LPhat24/Battery-Management-System-NCKH2026/Hardware/Box/in mau/LargeEdge_Color2.pdf

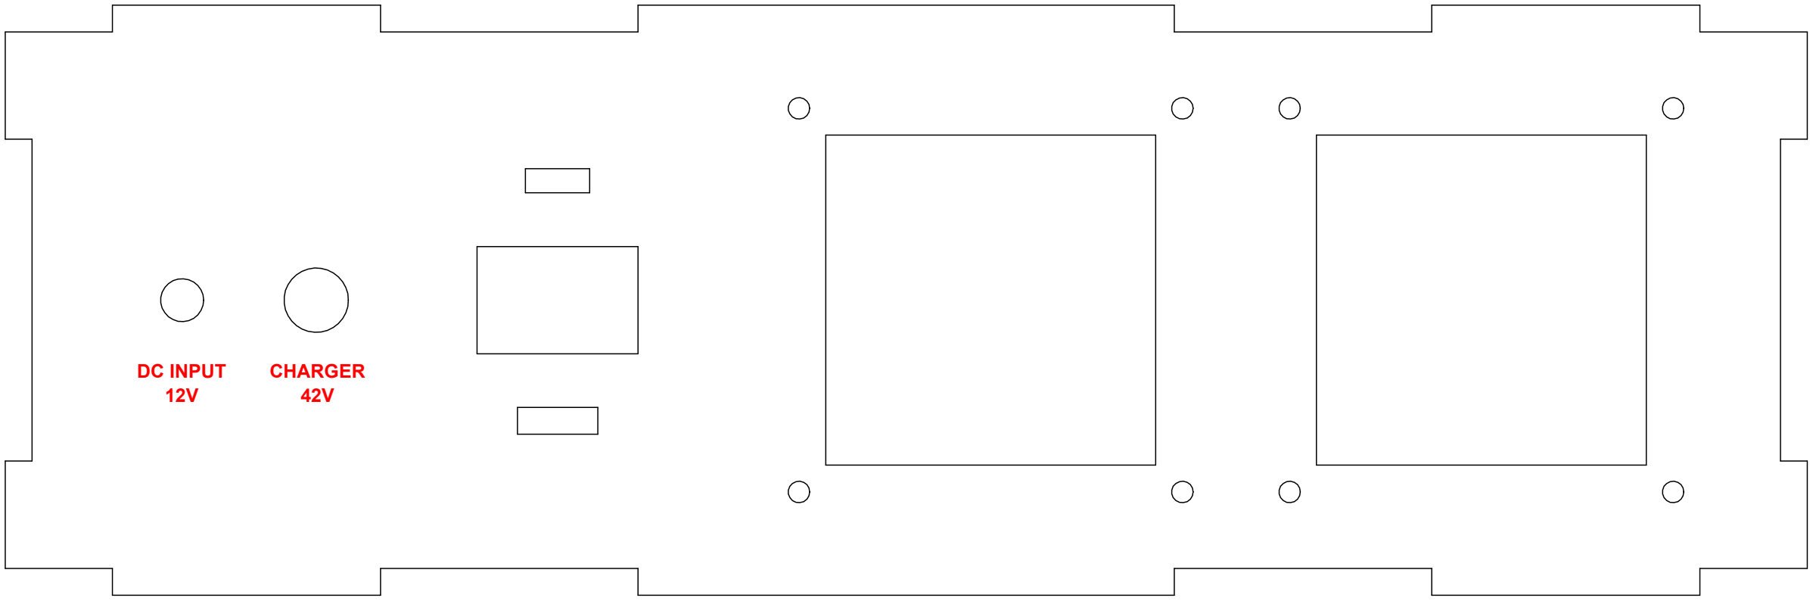
[picture p1: figure]
DC INPUT 12V; CHARGER 42V
