LPhat24/Battery-Management-System-NCKH2026/Hardware/Box/in mau/LargeEdge_Color.pdf

DC INPUT 12V; CHARGER 42V
