LPhat24/Battery-Management-System-NCKH2026/Docs/Huong Dan Host Repo.docx

# HƯỚNG DẪN DÀNH CHO LEADER REPOSITORY

## Dự án: Cruise Control DC Motor – LabVIEW & Arduino

Người quản lý Repository:

Le Thanh Phat

# 1. Trách nhiệm của Leader

Leader chịu trách nhiệm:

- Tạo và quản lý Repository GitHub.
- Thêm thành viên vào dự án.
- Quản lý cấu trúc thư mục.
- Kiểm tra lịch sử commit.
- Hỗ trợ xử lý lỗi Git.
- Tổng hợp source cuối cùng.
- Đảm bảo mọi người tuân thủ quy tắc làm việc.

# 2. Kiểm tra trạng thái Repository

git status

Ý nghĩa:

- Kiểm tra file mới.
- Kiểm tra file đã sửa.
- Kiểm tra trạng thái hiện tại của Repository.

Ví dụ:

nothing to commit, working tree clean

nghĩa là mọi thứ đã được đồng bộ.

# 3. Kiểm tra lịch sử Commit

git log --oneline

Ý nghĩa:

- Hiển thị toàn bộ lịch sử commit.
- Mỗi dòng là một phiên bản dự án.

Ví dụ:

a1b2c3d Doc: Add teamwork guide

e4f5g6h Initial project structure

# 4. Xem ai vừa Commit

git log

Ý nghĩa:

- Hiển thị:
  - Tên người commit.
  - Email.
  - Thời gian.
  - Nội dung commit.

Ví dụ:

Author: Nguyen Duy Thong

Date: ...

# 5. Kiểm tra Repository từ GitHub

git remote -v

Ý nghĩa:

- Hiển thị địa chỉ GitHub hiện tại.

Ví dụ:

origin https://github.com/xxxxx/Cruise-Control-DC-Motor-LabVIEW.git

# 6. Đồng bộ Repository

Trước khi làm việc:

git pull origin main

Ý nghĩa:

- Tải thay đổi mới nhất từ GitHub.

Nên thực hiện:

Mỗi ngày một lần.

hoặc

Trước khi bắt đầu làm việc.

# 7. Đẩy thay đổi của Leader

Thêm file:

git add .

Ý nghĩa:

- Thêm toàn bộ thay đổi vào vùng chuẩn bị commit.

Tạo commit:

git commit -m "Nội dung"

Ví dụ:

git commit -m "Doc: Update project guideline"

Đẩy lên GitHub:

git push origin main

Ý nghĩa:

- Upload commit từ máy tính lên GitHub.

# 8. Kiểm tra cây thư mục

tree /f /a

Ý nghĩa:

- Hiển thị toàn bộ file và thư mục.
- Dùng để kiểm tra thành viên có đặt file đúng vị trí hay không.

# 9. Kiểm tra thay đổi giữa các phiên bản

git diff

Ý nghĩa:

- So sánh file hiện tại với commit gần nhất.

# 10. Kiểm tra các file chưa được Git quản lý

git status

Ví dụ:

Untracked files:

Software/NguyenDuyThong/Test.ino

Ý nghĩa:

- Thành viên đã tạo file nhưng chưa commit.

# 11. Khôi phục file bị sửa

Khôi phục một file:

git restore <Tên file>

Ví dụ:

git restore README.md

Ý nghĩa:

- Hủy toàn bộ thay đổi chưa commit.

Cẩn thận vì không thể hoàn tác.

# 12. Xem các Branch

git branch

Ý nghĩa:

- Hiển thị các nhánh hiện có.

Ví dụ:

* main

# 13. Kiểm tra ai chưa Pull

Không có lệnh Git nào cho biết chính xác ai chưa Pull.

Leader nên yêu cầu thành viên:

git status

Nếu hiện:

Your branch is up to date with 'origin/main'

thì thành viên đã đồng bộ.

# 14. Quy tắc quản lý dự án

Mỗi thành viên chỉ làm việc trong thư mục của mình.

Ví dụ:

Software/NguyenDuyThong/

LabVIEW/HuynhPhuocDo/

Document/NguyenTienPhat/

Không tự ý sửa file của người khác.

# 15. Quy tắc Commit

Nội dung commit phải rõ ràng.

Ví dụ:

git commit -m "Software: Add encoder calculation"

git commit -m "LabVIEW: Create dashboard UI"

git commit -m "Hardware: Update wiring diagram"

git commit -m "Doc: Update project report"

Không sử dụng:

git commit -m "update"

git commit -m "fix"

vì không thể biết đã thay đổi gì.

# 16. Quy trình kiểm tra cuối tuần

Leader thực hiện:

git pull origin main

↓

git log --oneline

↓

tree /f /a

↓

Kiểm tra:

- Ai đã commit.
- Ai chưa commit.
- File có đúng vị trí không.
- Có file rác hay không.

# 17. Bộ lệnh Leader cần nhớ

git status

Kiểm tra trạng thái.

git pull origin main

Cập nhật Repository.

git add .

Thêm thay đổi.

git commit -m "..."

Tạo phiên bản mới.

git push origin main

Đẩy lên GitHub.

git log --oneline

Xem lịch sử commit.

git remote -v

Kiểm tra liên kết GitHub.

tree /f /a

Kiểm tra cấu trúc dự án.

git diff

Kiểm tra nội dung thay đổi.

Mục tiêu của Leader:

1. Không để mất dữ liệu.

2. Không để xảy ra xung đột file.

3. Luôn biết ai đã thay đổi gì.

4. Đảm bảo Repository luôn ở trạng thái ổn định.
