LPhat24/Battery-Management-System-NCKH2026/Docs/Huong Dan Teamwork GitHub.docx

# HƯỚNG DẪN TEAMWORK GITHUB

## Dự án: Cruise Control DC Motor – LabVIEW & Arduino

# 1. Mục tiêu

Sử dụng GitHub để:

- Đồng bộ source code giữa các thành viên.
- Lưu lịch sử thay đổi của dự án.
- Tránh mất dữ liệu khi làm việc nhóm.
- Quản lý tài liệu, hình ảnh, phần cứng, LabVIEW và Arduino trên cùng một repository.

# 2. Cài đặt Git

Tải Git:

https://git-scm.com/download/win

Cài đặt mặc định:

Next → Next → Next → Finish

Kiểm tra Git:

git --version

Ý nghĩa:

- Hiển thị phiên bản Git đang cài.
- Nếu hiện số phiên bản thì Git đã hoạt động.

# 3. Cấu hình Git lần đầu

Chỉ thực hiện 1 lần trên máy tính.

Khai báo tên:

git config --global user.name "Nguyen Van A"

Ý nghĩa:

- Khai báo tên người thực hiện commit.

Khai báo email:

git config --global user.email "abc@gmail.com"

Ý nghĩa:

- Khai báo email liên kết với GitHub.

Kiểm tra cấu hình:

git config --list

Ý nghĩa:

- Hiển thị toàn bộ cấu hình Git hiện tại.

# 4. Clone dự án từ GitHub

Di chuyển tới nơi muốn lưu dự án:

cd D:\Project

Ý nghĩa:

- cd = Change Directory.
- Di chuyển tới thư mục D:.

Clone repository:

git clone <Link Repository>

Ví dụ:

git clone https://github.com/xxxxx/Cruise-Control-DC-Motor-LabVIEW.git

Ý nghĩa:

- Tải toàn bộ project từ GitHub về máy.

Đi vào thư mục dự án:

cd Cruise-Control-DC-Motor-LabVIEW

Ý nghĩa:

- Chuyển tới thư mục dự án.

# 5. Cấu trúc thư mục dự án

Document/
├── HuynhPhuocDo
├── LeThanhPhat
├── NguyenDuyThong
└── NguyenTienPhat

Hardware/
├── HuynhPhuocDo
├── LeThanhPhat
├── NguyenDuyThong
└── NguyenTienPhat

Image/
├── HuynhPhuocDo
├── LeThanhPhat
├── NguyenDuyThong
└── NguyenTienPhat

LabVIEW/
├── HuynhPhuocDo
├── LeThanhPhat
├── NguyenDuyThong
└── NguyenTienPhat

Software/
├── HuynhPhuocDo
├── LeThanhPhat
├── NguyenDuyThong
└── NguyenTienPhat

# 6. Quy tắc làm việc

Mỗi thành viên chỉ làm việc trong thư mục mang tên mình.

Ví dụ:

NguyenDuyThong:

LabVIEW/NguyenDuyThong/
Software/NguyenDuyThong/
Document/NguyenDuyThong/

HuynhPhuocDo:

LabVIEW/HuynhPhuocDo/
Software/HuynhPhuocDo/
Document/HuynhPhuocDo/

Không chỉnh sửa file của người khác nếu chưa trao đổi.

Mục đích:

- Tránh xung đột Git.
- Tránh ghi đè file LabVIEW.
- Dễ theo dõi công việc từng người.

# 7. Các lệnh kiểm tra cơ bản

Hiển thị cây thư mục:

tree /f /a

Ý nghĩa:

- Hiển thị toàn bộ file và thư mục.

Kiểm tra đang đứng ở đâu:

pwd

Ý nghĩa:

- Hiển thị thư mục hiện tại.

Kiểm tra trạng thái Git:

git status

Ý nghĩa:

- Xem file nào đã thay đổi.
- Xem file mới được tạo.
- Kiểm tra trạng thái repository.

# 8. Quy trình làm việc hằng ngày

## Bước 1

Trước khi làm việc

git pull origin main

Ý nghĩa:

- Tải phiên bản mới nhất từ GitHub.
- Đồng bộ với các thành viên khác.

## Bước 2

Thực hiện công việc trong thư mục của mình.

Ví dụ:

LabVIEW/NguyenDuyThong/

hoặc

Software/HuynhPhuocDo/

## Bước 3

Kiểm tra thay đổi

git status

Ý nghĩa:

- Xem những file vừa chỉnh sửa.

## Bước 4

Đưa file vào vùng chuẩn bị commit

git add .

Ý nghĩa:

- Thêm toàn bộ thay đổi vào vùng chờ commit.

Dấu chấm . nghĩa là:

Thư mục hiện tại và toàn bộ thư mục con.

## Bước 5

Tạo commit

git commit -m "Mô tả công việc"

Ví dụ:

git commit -m "LabVIEW: Add dashboard interface"

hoặc

git commit -m "Software: Add encoder speed calculation"

Ý nghĩa:

- Lưu lại một phiên bản mới của dự án.
- Ghi chú nội dung công việc đã thực hiện.

## Bước 6

Đẩy lên GitHub

git push origin main

Ý nghĩa:

- Upload commit từ máy tính lên GitHub.

# 9. Bộ lệnh tối thiểu cần nhớ

Đi vào thư mục:

cd <Tên thư mục>

Ví dụ:

cd Software

Quay lại một cấp:

cd ..

Kiểm tra trạng thái:

git status

Tải cập nhật mới nhất:

git pull origin main

Thêm thay đổi:

git add .

Tạo commit:

git commit -m "Nội dung công việc"

Đẩy lên GitHub:

git push origin main

Xem cây thư mục:

tree /f /a

# 10. Quy trình chuẩn cần nhớ

Mỗi lần làm việc:

git pull origin main

↓

Thực hiện công việc

↓

git status

↓

git add .

↓

git commit -m "Mô tả công việc"

↓

git push origin main

Chỉ cần nhớ đúng quy trình trên là có thể làm việc nhóm an toàn trên GitHub.
