LPhat24/Battery-Management-System-NCKH2026/Docs/MASTER PCB/LAYOUT/BOTTOM LAYER.png

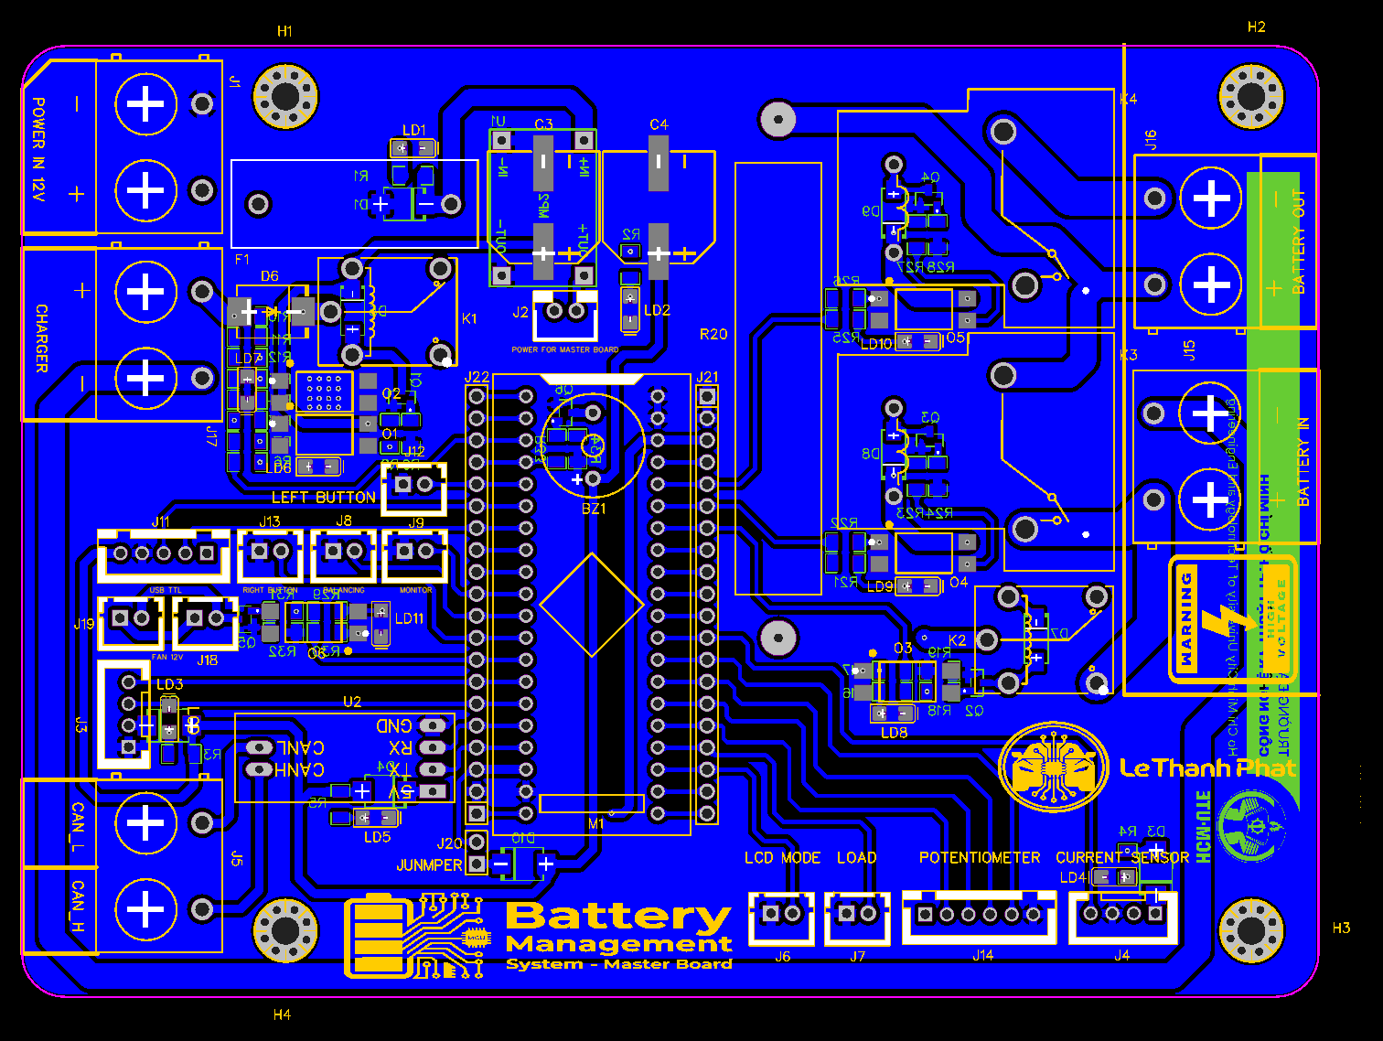
Docs/MASTER PCB/LAYOUT/BOTTOM LAYER.png
