LPhat24/Battery-Management-System-NCKH2026/Docs/MASTER PCB/SCHEMATIC/Schematic_PCB_VIP_Master-BMS-2026_2026-09-06.png

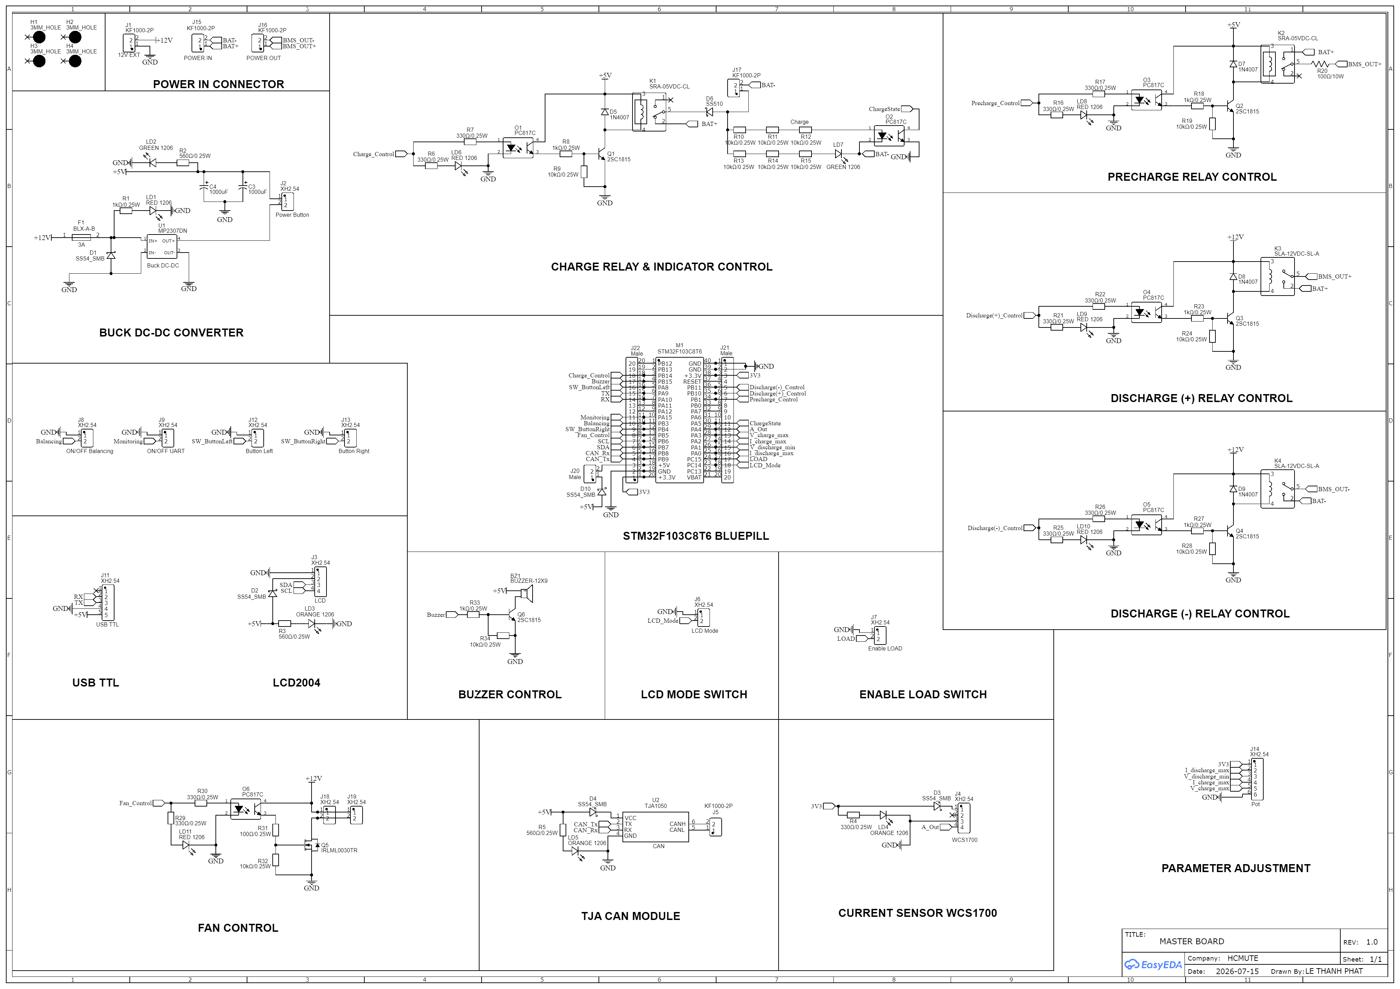
Docs/MASTER PCB/SCHEMATIC/Schematic_PCB_VIP_Master-BMS-2026_2026-09-06.png
