LPhat24/Battery-Management-System-NCKH2026/Docs/SLAVE PCB/LAYOUT/TOP LAYER.png

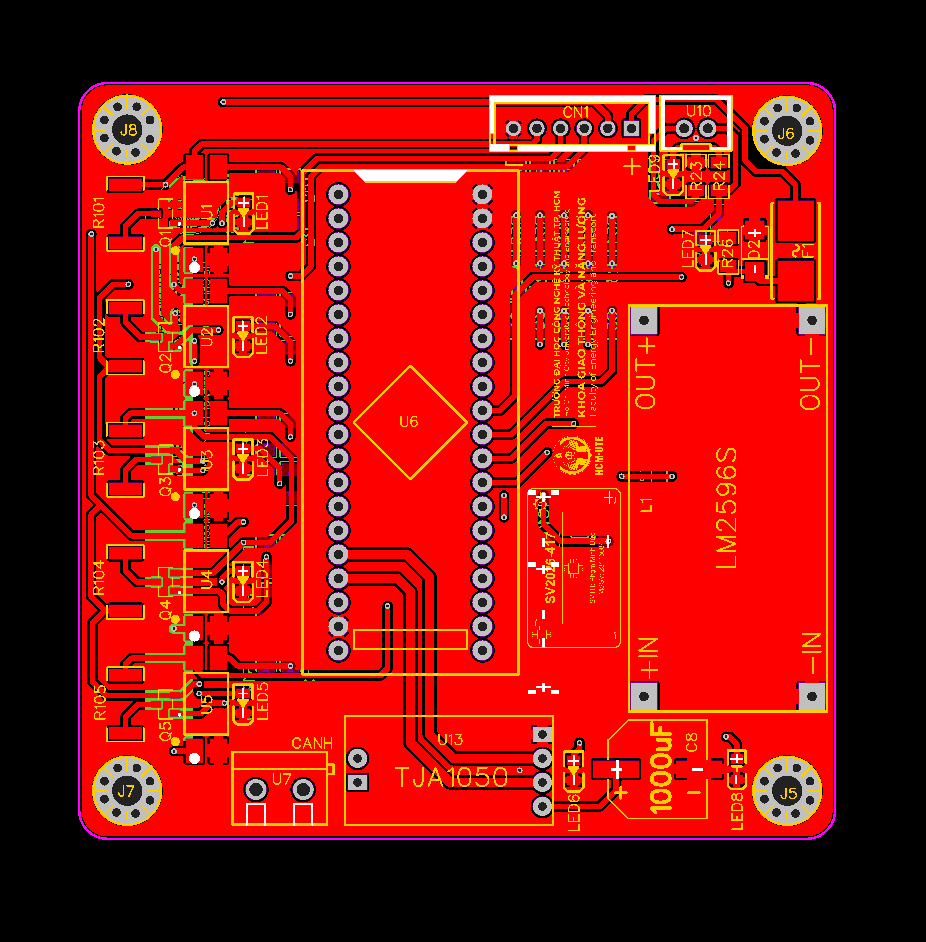
Docs/SLAVE PCB/LAYOUT/TOP LAYER.png
