LPhat24/Battery-Management-System-NCKH2026/Images/Screenshot 2026-09-05 204802.png

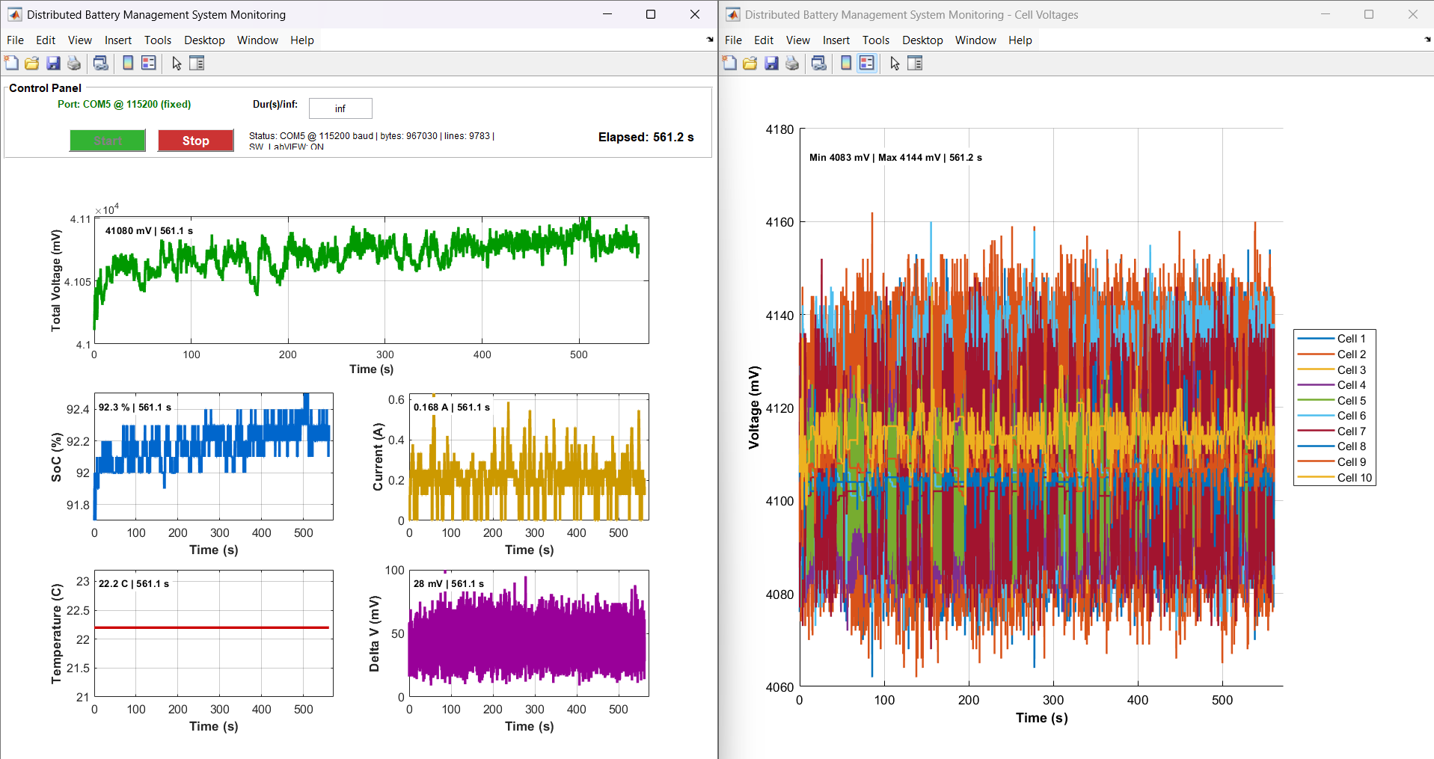
Images/Screenshot 2026-09-05 204802.png
