LPhat24/Battery-Management-System-NCKH2026/Hardware/Box/5s2p Battery.SLDASM

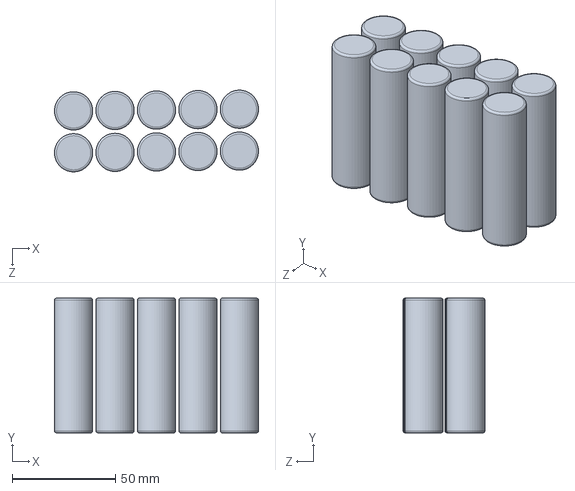
[picture p9: CAD file, 2026-08-03]
Hardware/Box/5s2p Battery.SLDASM
98.7 x 65.2 x 39.5 mm
Cell x 10
