LPhat24/Battery-Management-System-NCKH2026/Hardware/Box/Cat mica Box/LargeEdge.DXF

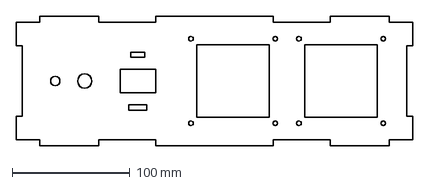
[picture p10: CAD file, 2026-08-04]
Hardware/Box/Cat mica Box/LargeEdge.DXF
336.0 x 110.0 mm
