LPhat24/Battery-Management-System-NCKH2026/Hardware/Box/Top.SLDPRT

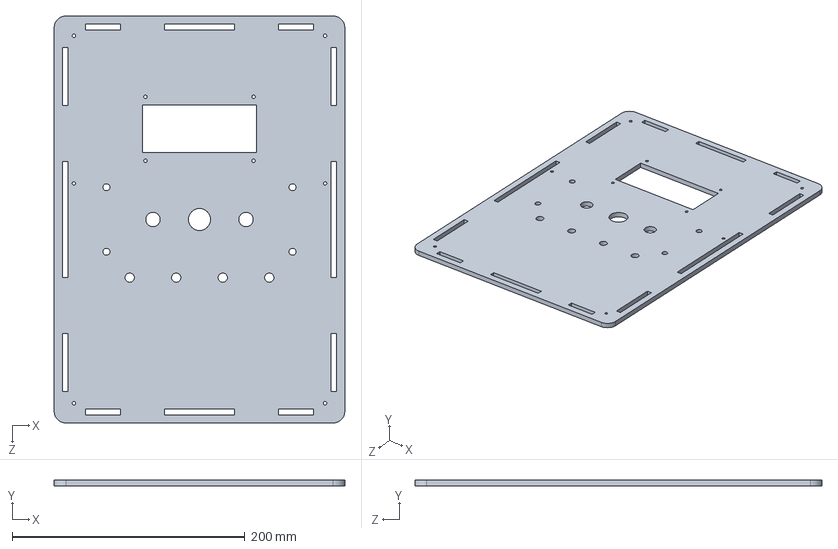
[picture p11: CAD file, 2026-08-04]
Hardware/Box/Top.SLDPRT
250.0 x 5.00 x 350.0 mm
