LPhat24/Battery-Management-System-NCKH2026/Hardware/Box/Cat mica Box/SmallEdge.DXF

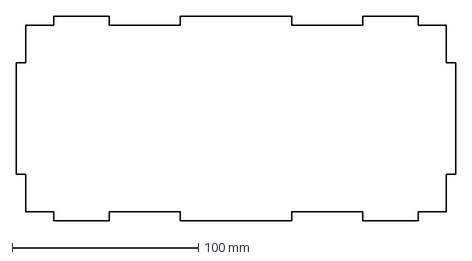
[picture p12: CAD file, 2026-08-04]
Hardware/Box/Cat mica Box/SmallEdge.DXF
236.0 x 110.0 mm
