LPhat24/Battery-Management-System-NCKH2026/Hardware/Box/rocker switch.SLDPRT

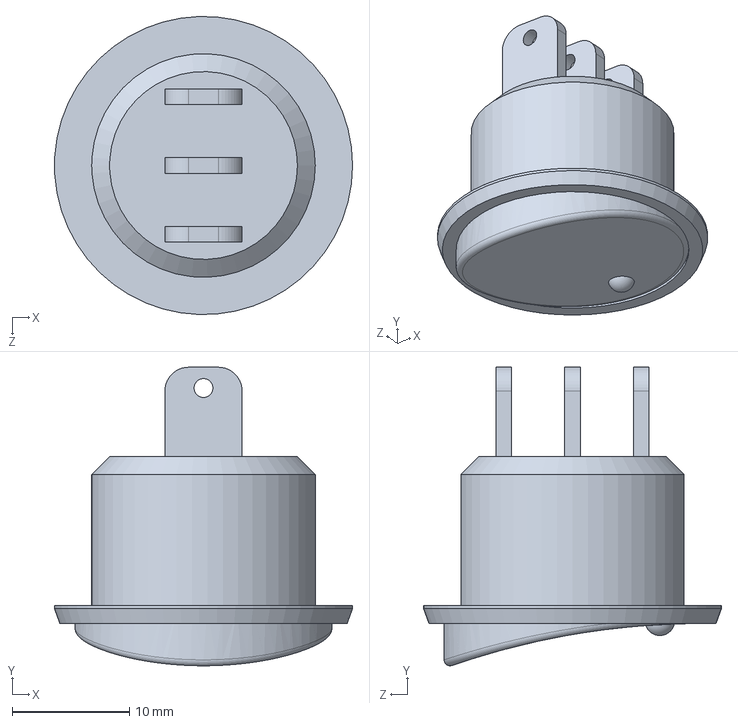
[picture p13: CAD file, 2026-08-03]
Hardware/Box/rocker switch.SLDPRT
25.4 x 25.4 x 25.4 mm
