LPhat24/Battery-Management-System-NCKH2026/Hardware/Box/Cat mica Box/LargeEdge_Right.DXF

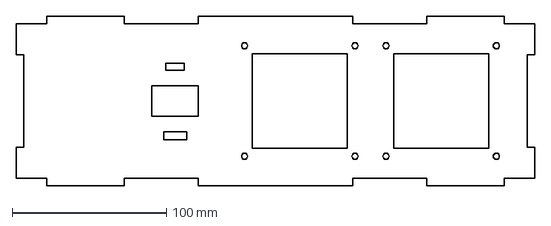
[picture p14: CAD file, 2026-08-04]
Hardware/Box/Cat mica Box/LargeEdge_Right.DXF
336.0 x 110.0 mm
