LPhat24/Battery-Management-System-NCKH2026/Hardware/Box/FAN_80x80x25.SLDPRT

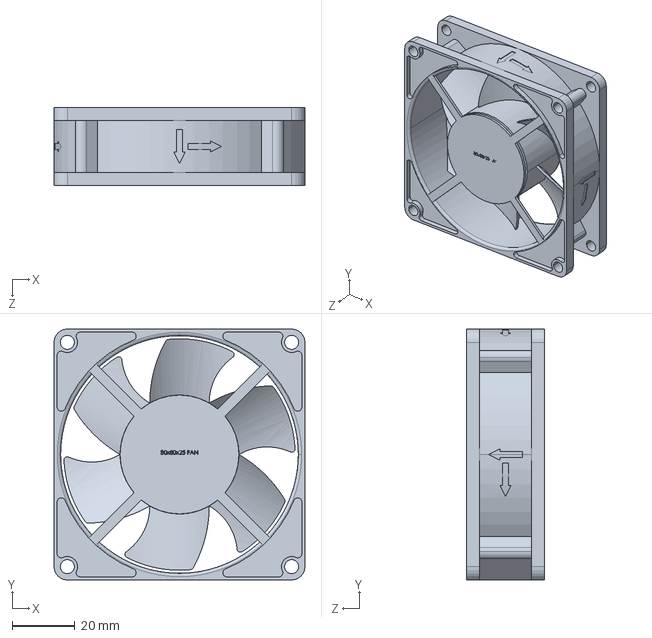
[picture p15: CAD file, 2026-08-03]
Hardware/Box/FAN_80x80x25.SLDPRT
80.0 x 80.0 x 25.0 mm
