LPhat24/Battery-Management-System-NCKH2026/Hardware/Box/Cat mica Box/Bottom2.DXF

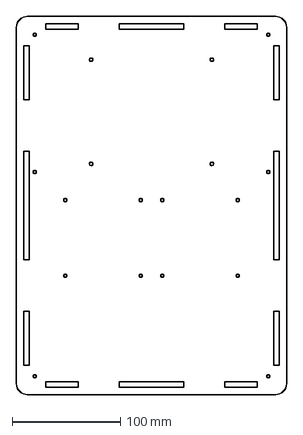
[picture p16: CAD file, 2026-08-04]
Hardware/Box/Cat mica Box/Bottom2.DXF
250.0 x 350.0 mm
