LPhat24/Battery-Management-System-NCKH2026/Hardware/Box/LargeEdge.SLDPRT

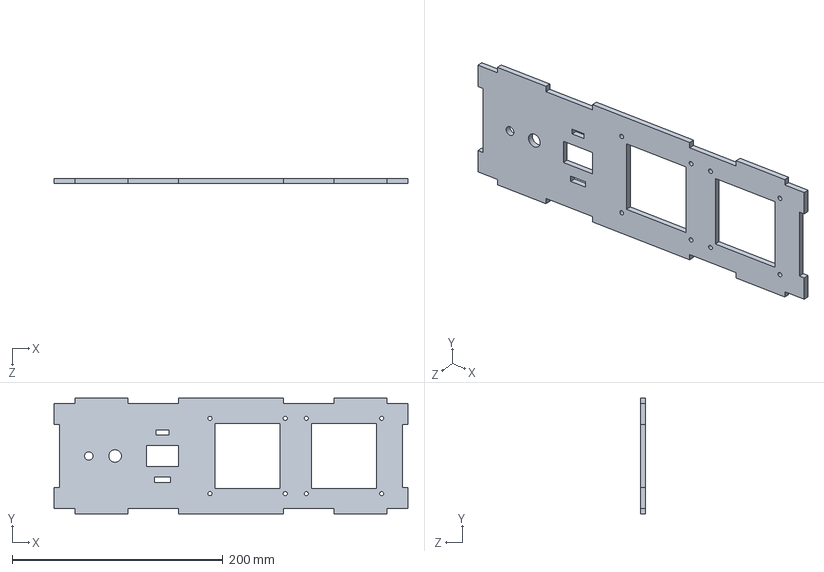
[picture p17: CAD file, 2026-08-03]
Hardware/Box/LargeEdge.SLDPRT
336.0 x 110.0 x 5.00 mm
