LPhat24/Battery-Management-System-NCKH2026/Hardware/Box/Cat mica Box/Top.DXF

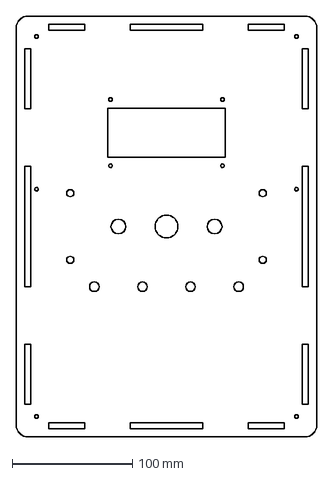
[picture p18: CAD file, 2026-08-04]
Hardware/Box/Cat mica Box/Top.DXF
250.0 x 350.0 mm
