LPhat24/Battery-Management-System-NCKH2026/Hardware/Box/Potentiometer.SLDPRT

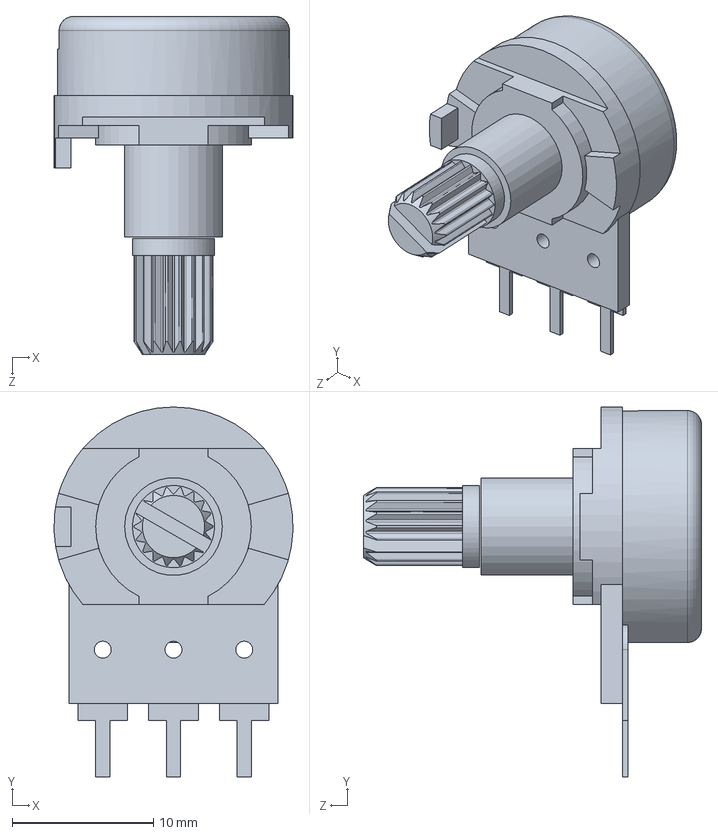
[picture p19: CAD file, 2026-08-03]
Hardware/Box/Potentiometer.SLDPRT
16.9 x 26.1 x 23.9 mm
