LPhat24/Battery-Management-System-NCKH2026/Hardware/Box/PCB_Standoff_50mm.SLDPRT

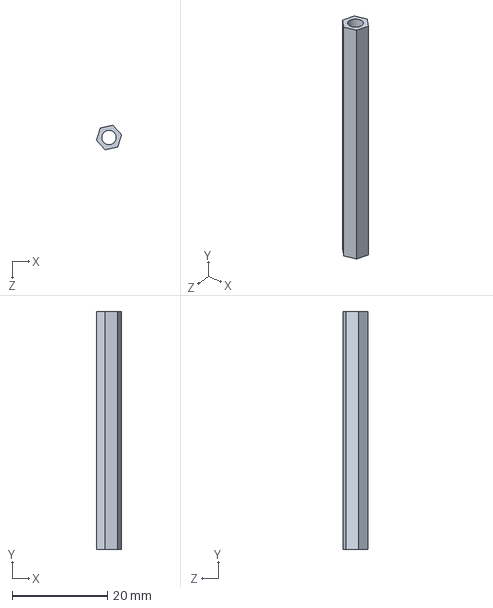
[picture p21: CAD file, 2026-08-03]
Hardware/Box/PCB_Standoff_50mm.SLDPRT
5.30 x 50.0 x 5.17 mm
