LPhat24/Battery-Management-System-NCKH2026/Hardware/Box/Bottom2.SLDPRT

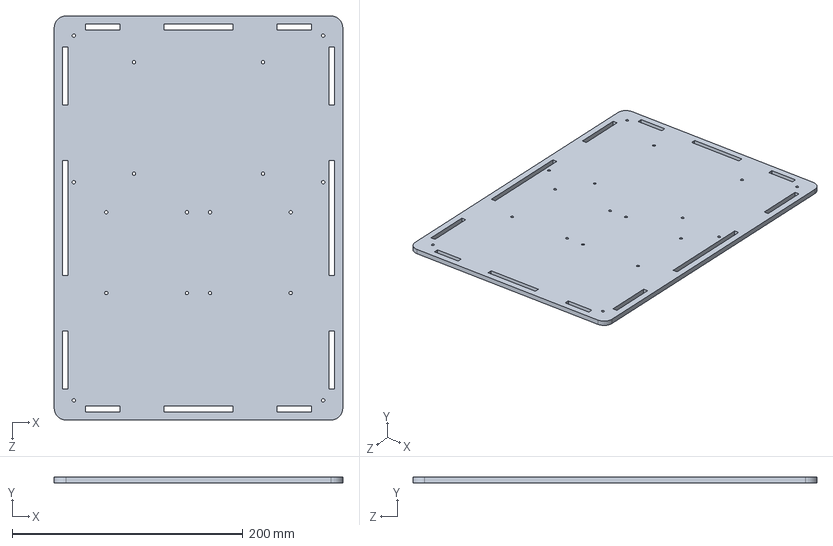
[picture p23: CAD file, 2026-08-03]
Hardware/Box/Bottom2.SLDPRT
250.0 x 5.00 x 350.0 mm
