LPhat24/Battery-Management-System-NCKH2026/Hardware/Box/Push Button.SLDPRT

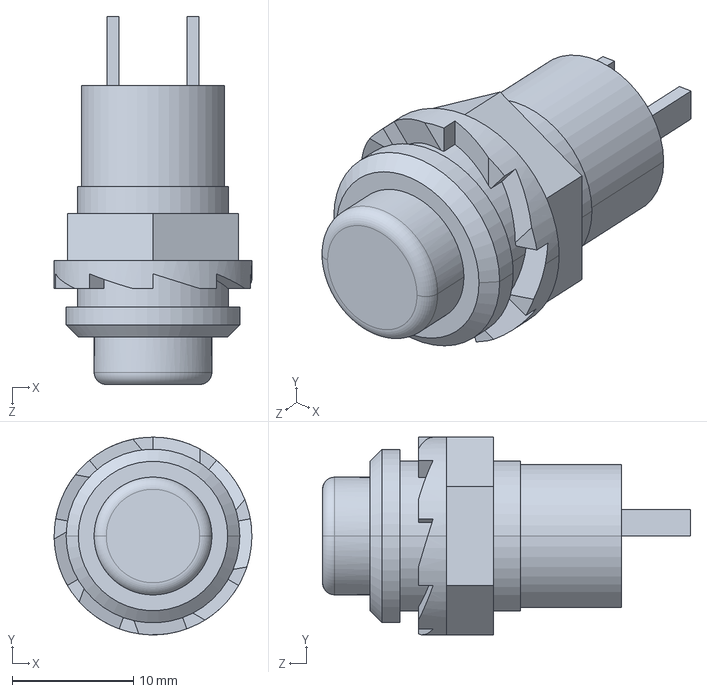
[picture p24: CAD file, 2026-08-03]
Hardware/Box/Push Button.SLDPRT
16.3 x 16.3 x 30.3 mm
