LPhat24/Battery-Management-System-NCKH2026/Hardware/Box/PCB_Standoff.SLDPRT

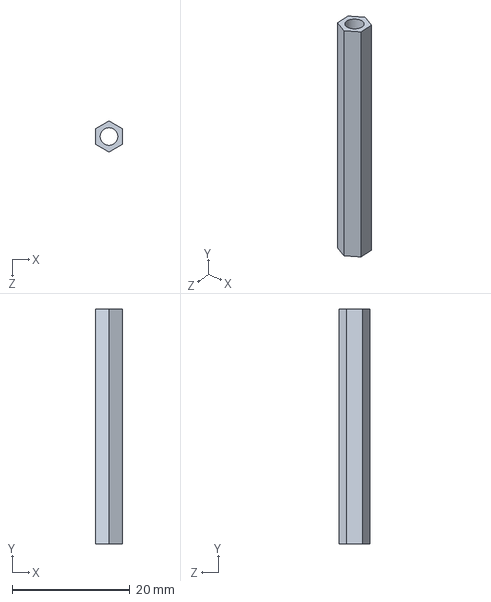
[picture p25: CAD file, 2026-08-03]
Hardware/Box/PCB_Standoff.SLDPRT
4.59 x 40.0 x 5.30 mm
