LPhat24/Battery-Management-System-NCKH2026/Hardware/Box/SmallEdge.SLDPRT

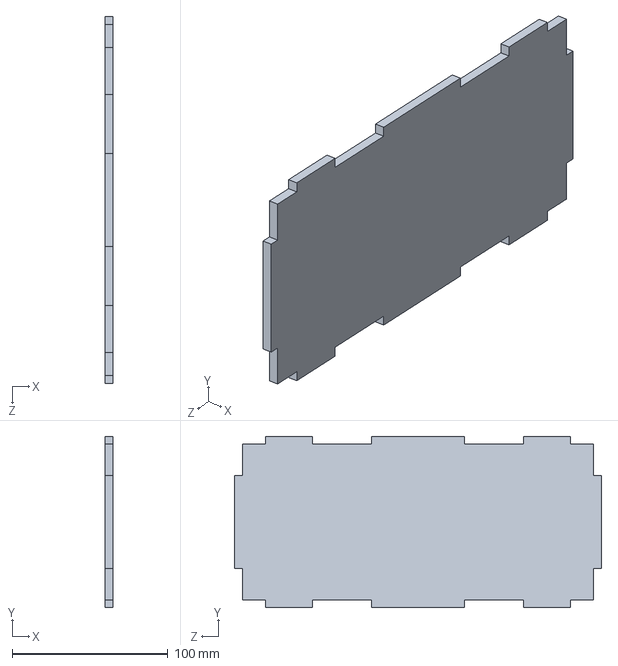
[picture p26: CAD file, 2026-08-03]
Hardware/Box/SmallEdge.SLDPRT
5.00 x 110.0 x 236.0 mm
