LPhat24/Battery-Management-System-NCKH2026/Hardware/Box/LCD 2004 +I2C.SLDPRT

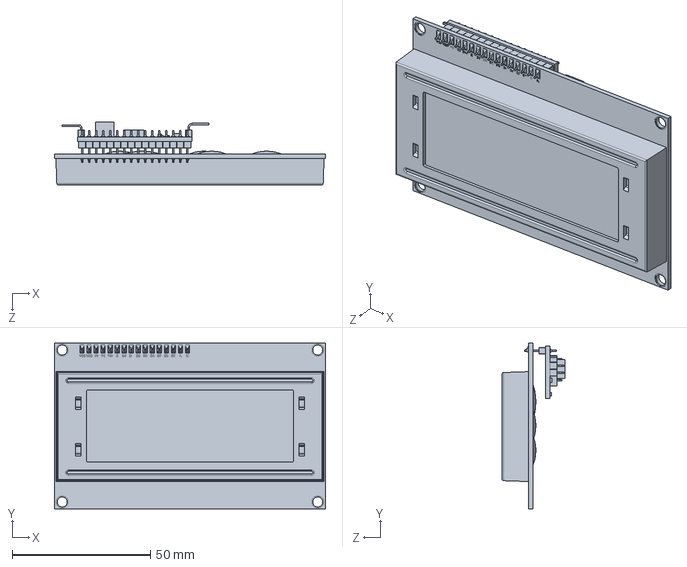
[picture p27: CAD file, 2026-08-03]
Hardware/Box/LCD 2004 +I2C.SLDPRT
98.1 x 60.1 x 22.7 mm
