LPhat24/Battery-Management-System-NCKH2026/Hardware/Box/MTS-102.SLDPRT

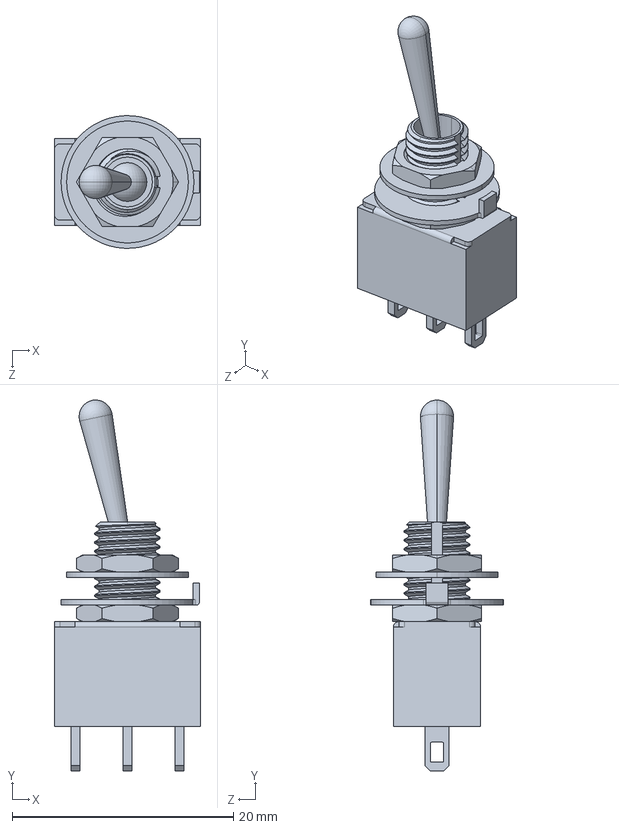
[picture p28: CAD file, 2026-08-03]
Hardware/Box/MTS-102.SLDPRT
13.2 x 33.5 x 12.0 mm
