LPhat24/Battery-Management-System-NCKH2026/Hardware/Box/Cell.SLDPRT

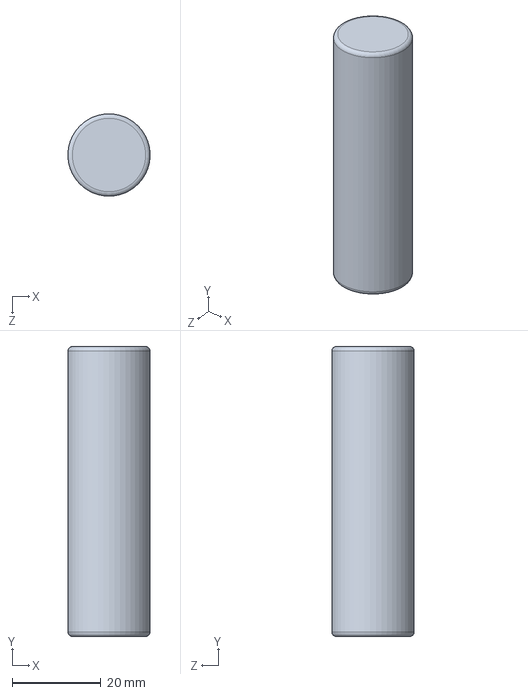
[picture p29: CAD file, 2026-08-03]
Hardware/Box/Cell.SLDPRT
18.5 x 65.2 x 18.5 mm
