LPhat24/Battery-Management-System-NCKH2026/(list of files, cad)

Other CAD files:
Hardware/Box/LargeEdge_Right.SLDPRT
Hardware/Box/18650 2PCS KEEPER.SLDPRT
Hardware/Box/LargeEdge.SLDDRW
Hardware/Box/SmallEdge_OUTPUT.SLDDRW
Hardware/Box/Top Custom.SLDDRW
