LPhat24/Battery-Management-System-NCKH2026/Images/FirstTest_Fig1_JPG.jpg

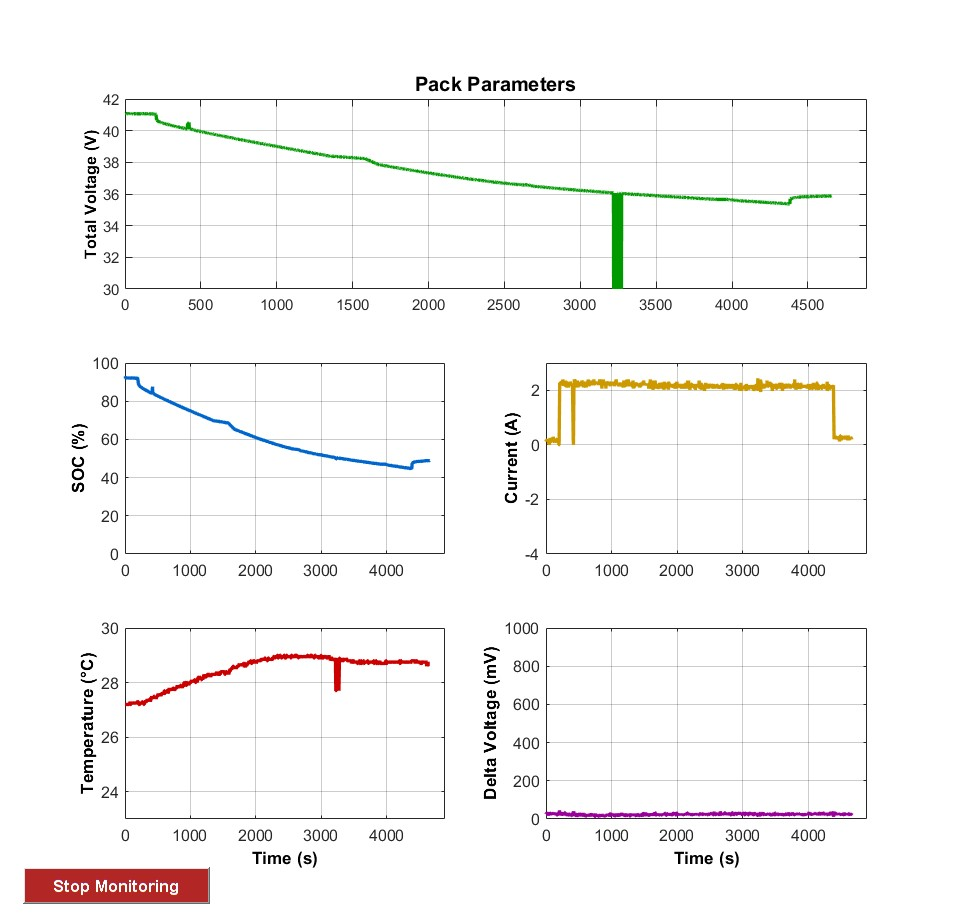
Images/FirstTest_Fig1_JPG.jpg
