LPhat24/Battery-Management-System-NCKH2026/Images/FirstTest_Fig2_JPG.jpg

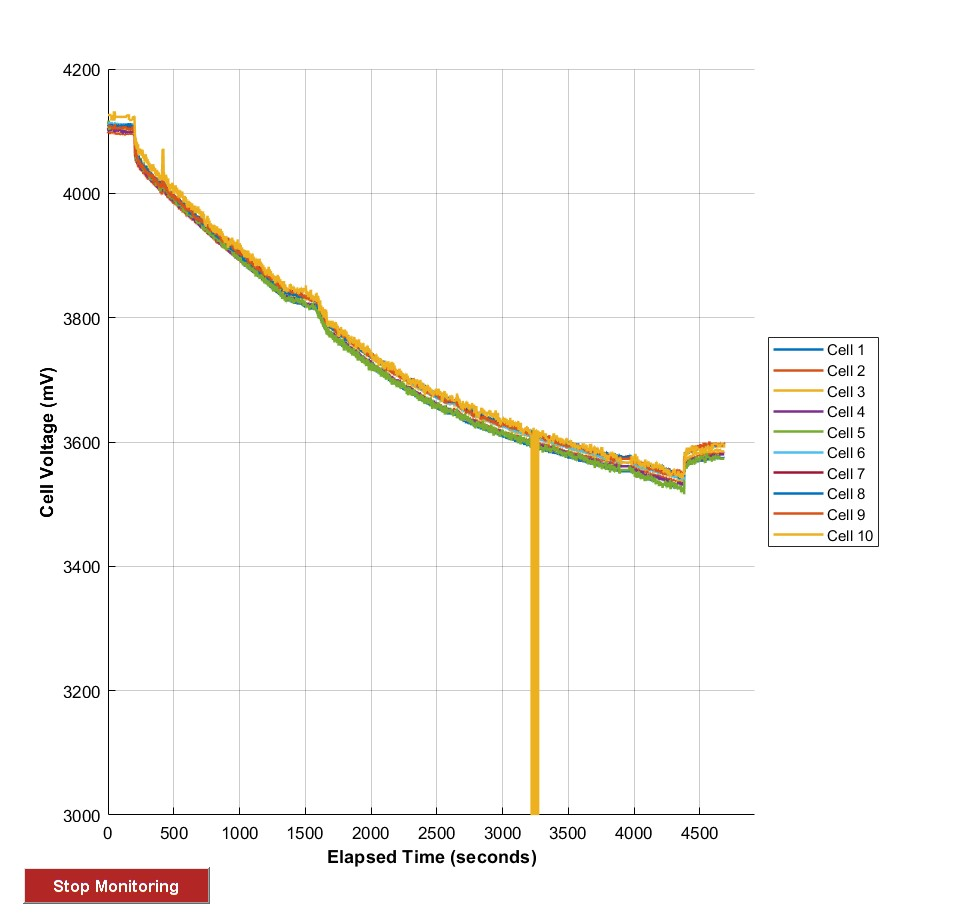
Images/FirstTest_Fig2_JPG.jpg
