LPhat24/Battery-Management-System-NCKH2026/Images/SecondTest_Fig1_JPG.jpg

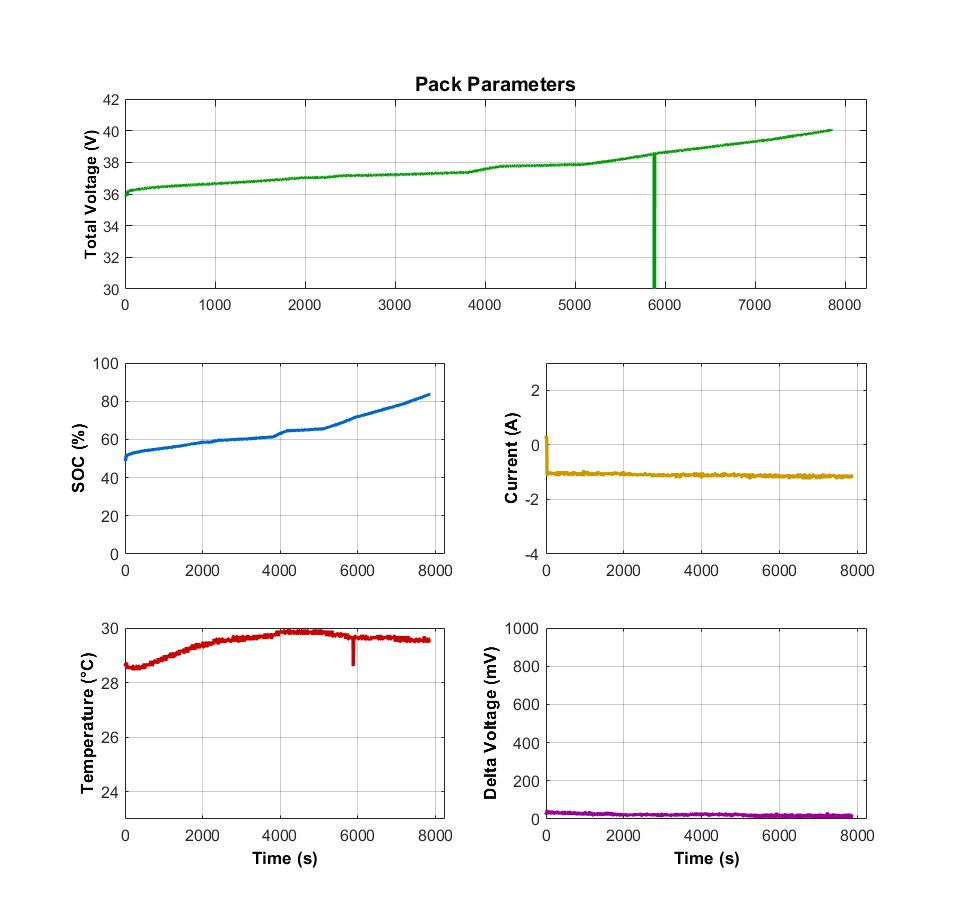
Images/SecondTest_Fig1_JPG.jpg
