LPhat24/Battery-Management-System-NCKH2026/Docs/MASTER PCB/SCHEMATIC/Schematic_PCB_VIP_Master-BMS-2026_2026-09-06.pdf

# POWER IN CONNECTOR

# PRECHARGE RELAY CONTROL

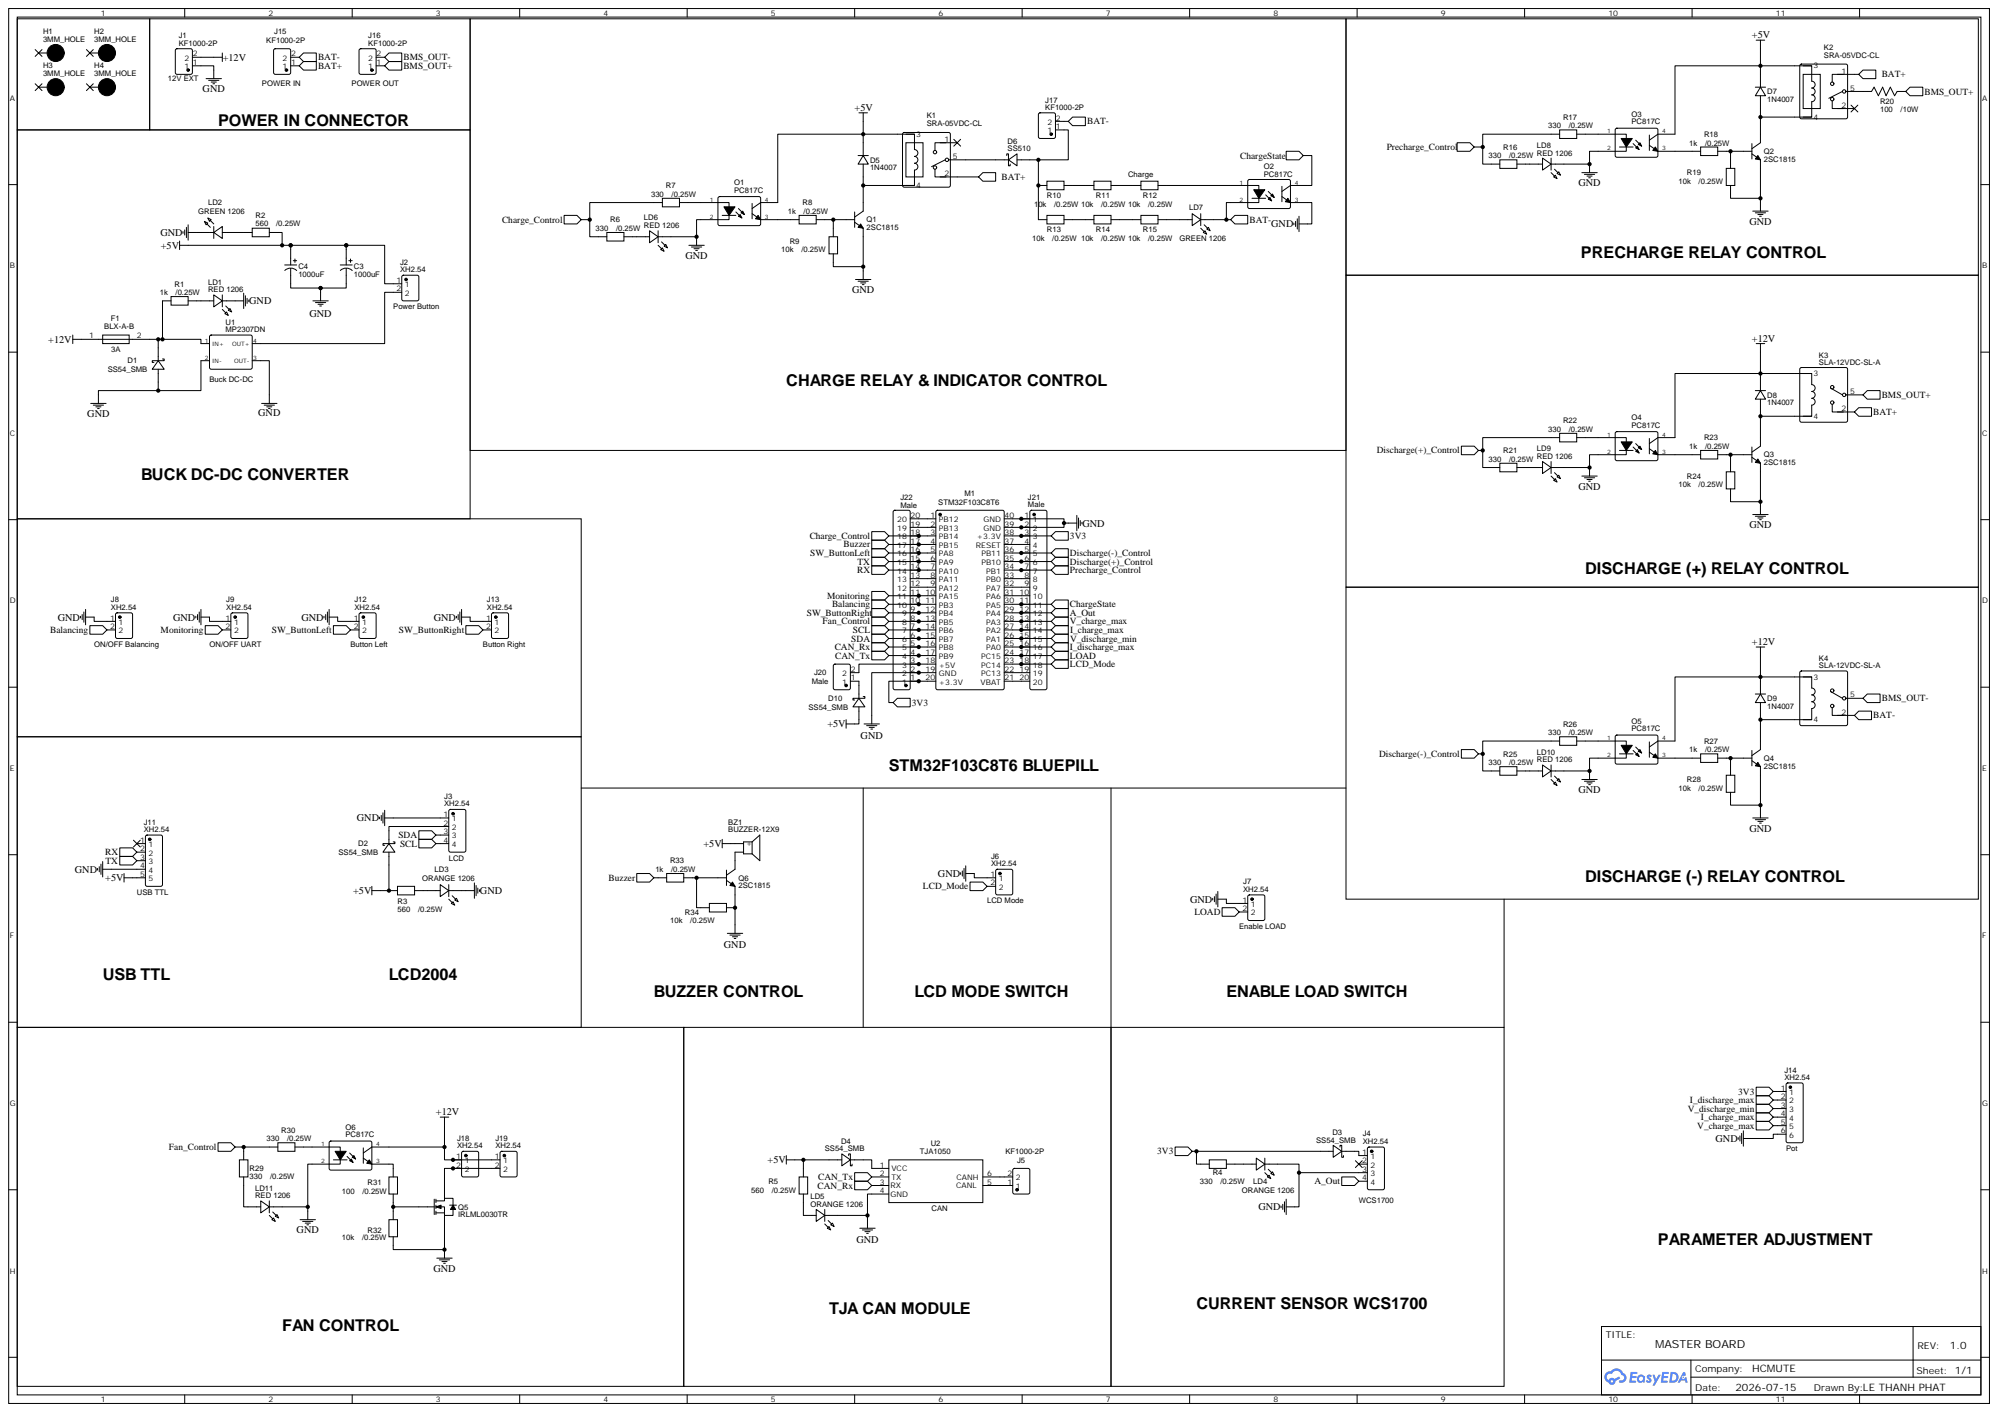
[picture p34: page 1]

CHARGE RELAY & INDICATOR CONTROL

BUCK DC-DC CONVERTER
