LPhat24/Battery-Management-System-NCKH2026/Hardware/Box/in mau/Top_Color2.pdf

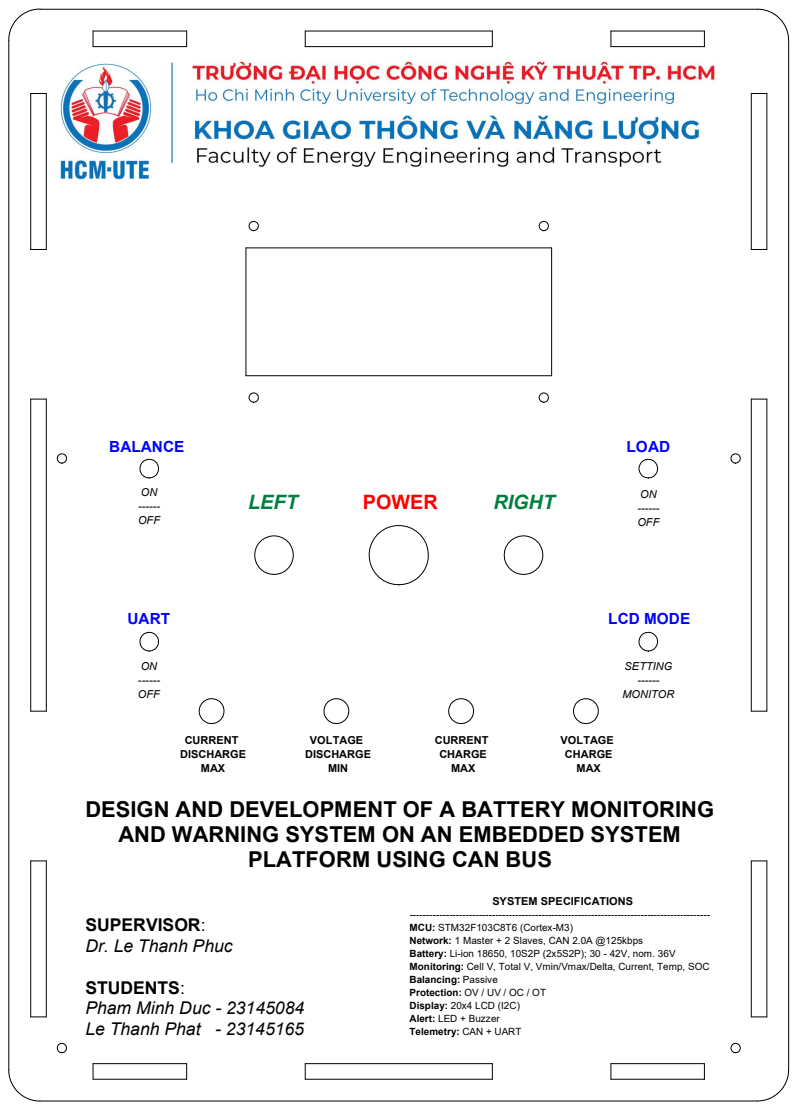
[picture p35: page 1]
BALANCE; LOAD; UART; LCD MODE; LEFT; POWER; RIGHT; OFF; MONITOR; SETTING; MIN; DISCHARGE; CURRENT; VOLTAGE; MAX; CHARGE; SYSTEM SPECIFICATIONS

DESIGN AND DEVELOPMENT OF A BATTERY MONITORING
AND WARNING SYSTEM ON AN EMBEDDED SYSTEM

PLATFORM USING CAN BUS

MCU: STM32F103C8T6 (Cortex-M3)
Network: 1 Master + 2 Slaves, CAN 2.0A @125kbps
Battery: Li-ion 18650, 10S2P (2x5S2P); 30 - 42V, nom. 36V
Monitoring: Cell V, Total V, Vmin/Vmax/Delta, Current, Temp, SOC
Balancing: Passive
Protection: OV / UV / OC / OT
Display: 20x4 LCD (I2C)
Alert: LED + Buzzer
Telemetry: CAN + UART

SUPERVISOR:
Dr. Le Thanh Phuc

STUDENTS
Pham Minh Duc - 23145084
Le Thanh Phat - 23145165
