LPhat24/Battery-Management-System-NCKH2026/Docs/SLAVE PCB/SCHEMATIC/Schematic_PCB_VIP-Slave-BMS-2026_2026-09-06.pdf

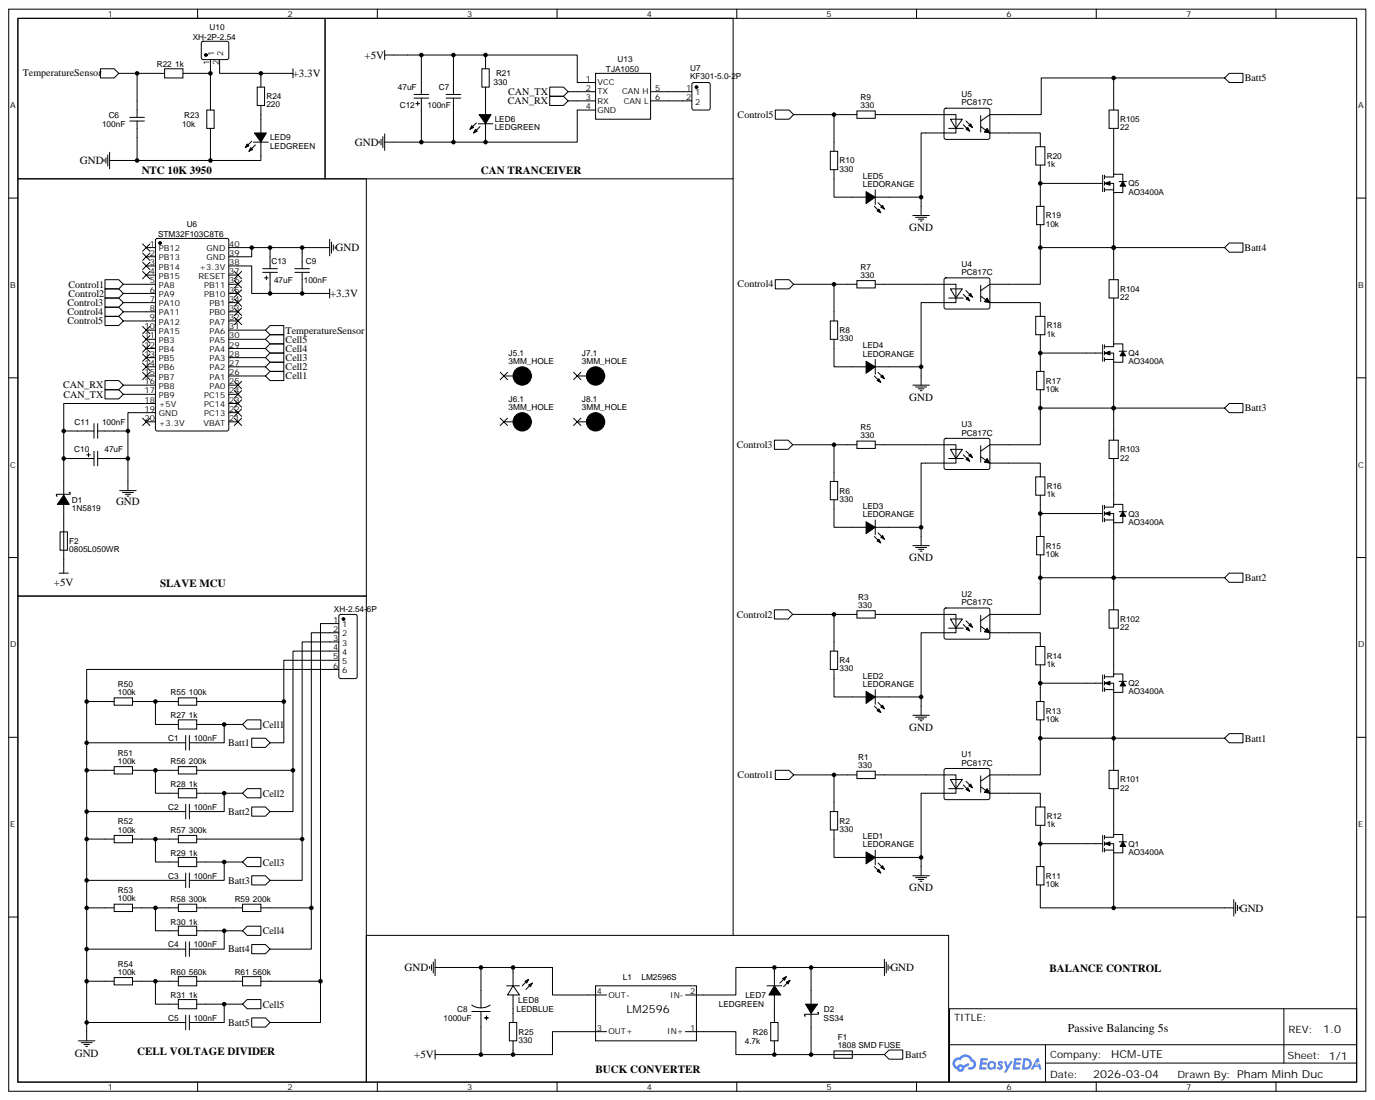
[picture p36: page 1]

Drawn By: Pham Minh Duc
