LPhat24/Battery-Management-System-NCKH2026/Docs/MASTER PCB/LAYOUT/BOTTOM LAYER.pdf

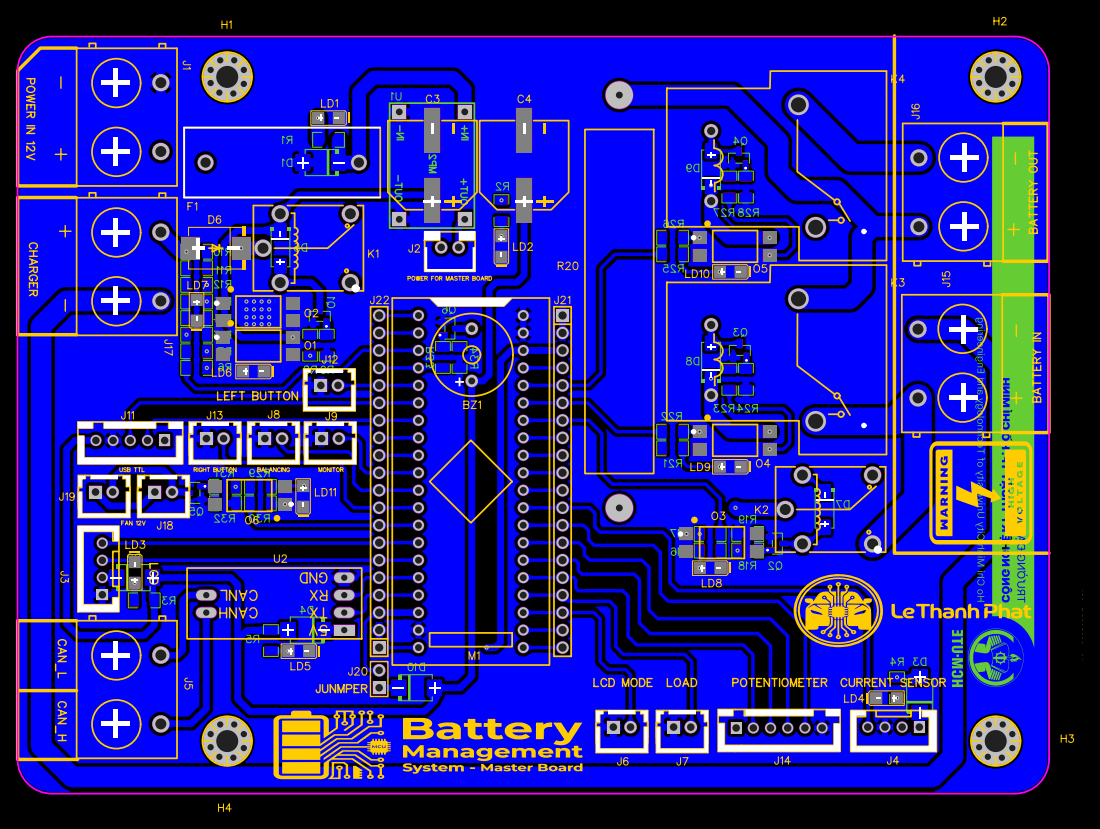
[picture p37: page 1]
