LPhat24/Battery-Management-System-NCKH2026/Docs/MASTER PCB/LAYOUT/TOP LAYER.pdf

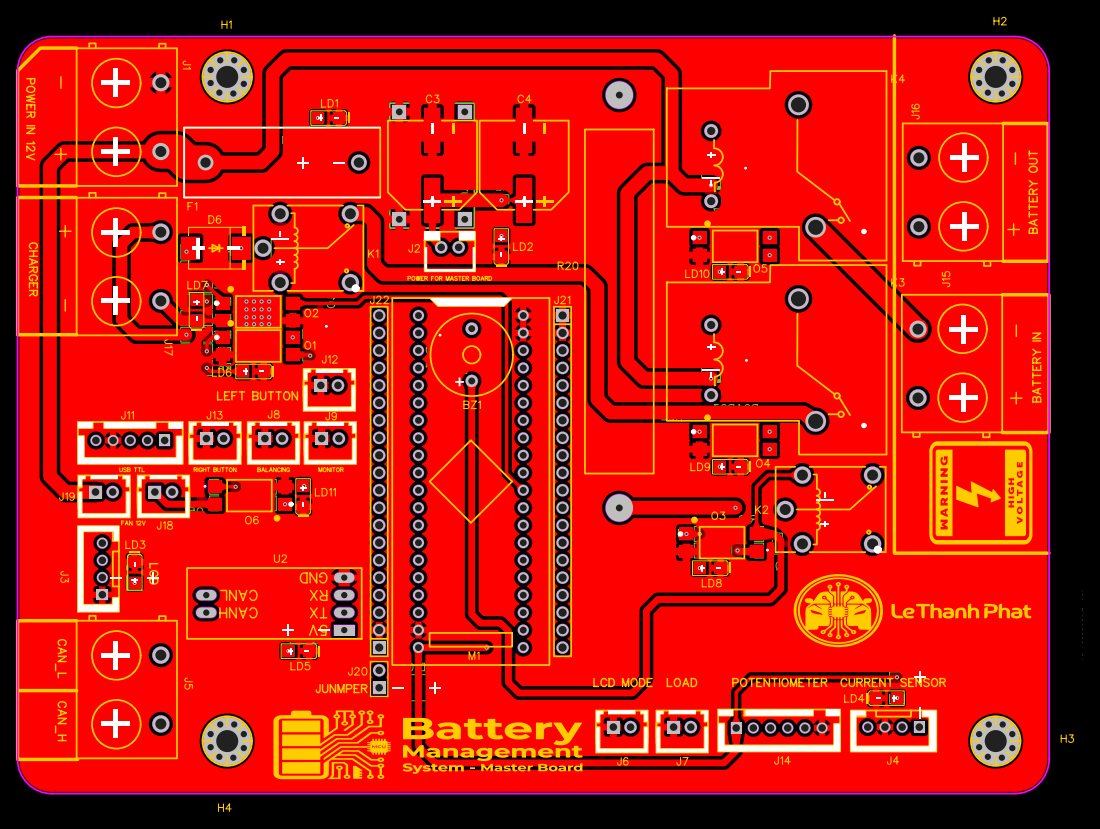
[picture p38: page 1]
