LPhat24/Battery-Management-System-NCKH2026/Docs/SLAVE PCB/LAYOUT/BOTTOM LAYER.pdf

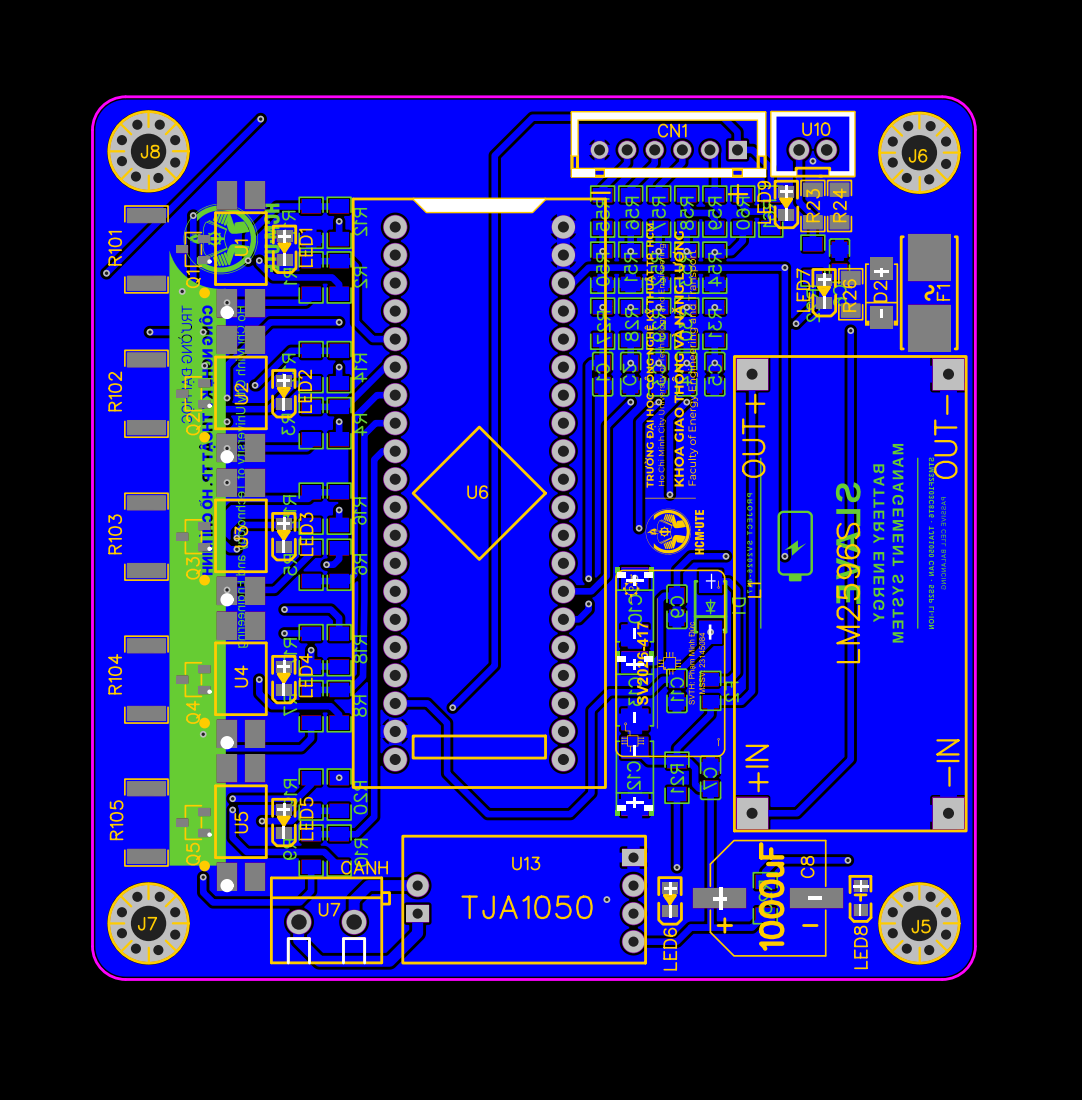
[picture p39: page 1]
