LPhat24/Battery-Management-System-NCKH2026/Docs/SLAVE PCB/LAYOUT/TOP LAYER.pdf

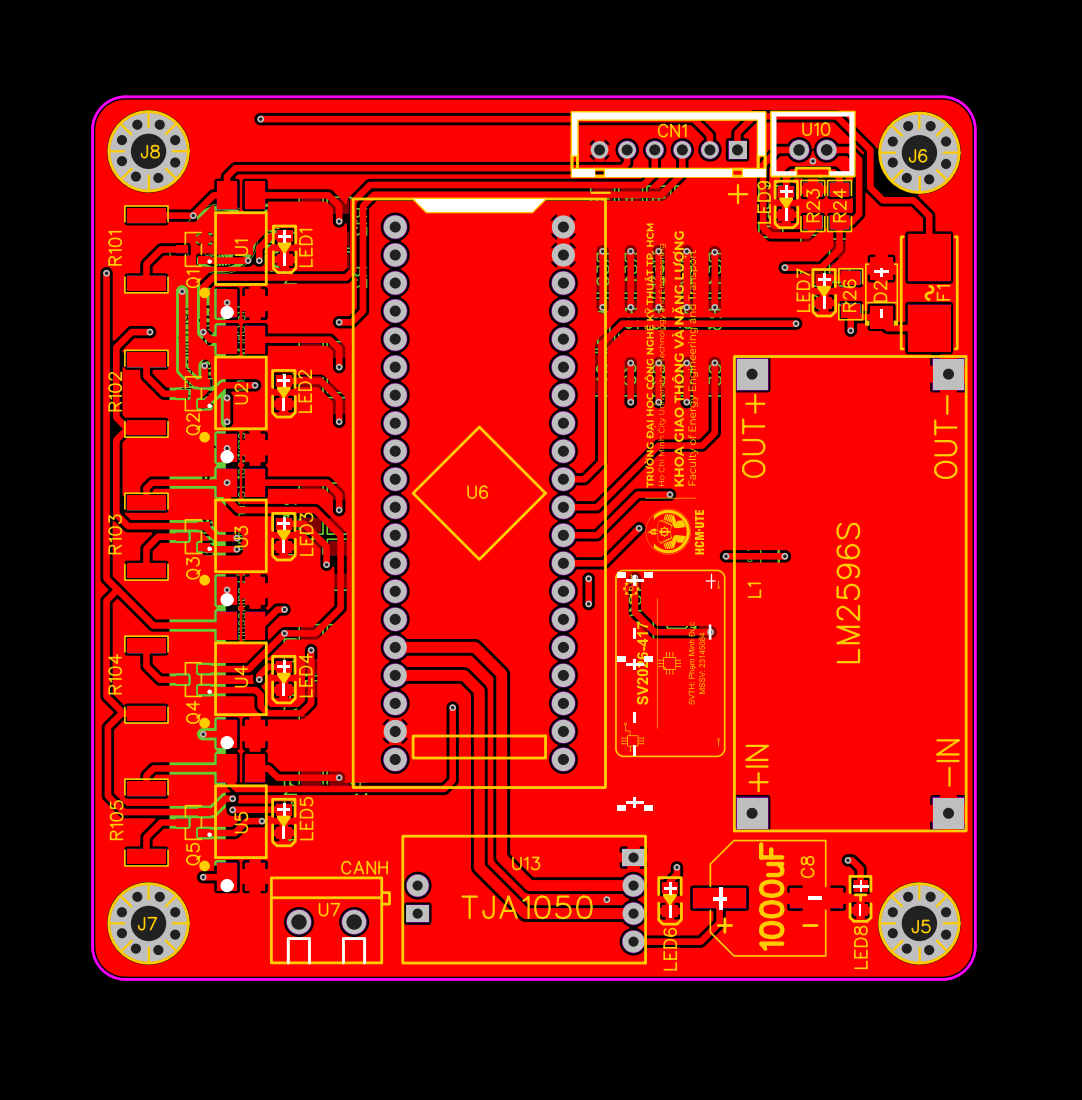
[picture p40: page 1]
