LPhat24/Battery-Management-System-NCKH2026/(list of files, drawings)

Other design files:
Hardware/Master Board/PCB_VIP_Master BMS 2026/PCB_PCB_VIP_Master BMS 2026.json
Hardware/Master Board/PCB_VIP_Master BMS 2026/PCB_VIP_Master BMS 2026.json
Hardware/Slave Board/PCB_VIP Slave BMS 2026/PCB_VIP Slave BMS 2026.json
