LPhat24/Battery-Management-System-NCKH2026/Software/Master/Master.ioc

Mcu.UserName=STM32F103C8Tx
PA0-WKUP.Signal=ADCx_IN0
PA1.Signal=ADCx_IN1
PA10.Signal=USART1_RX
PA13.Signal=SYS_JTMS-SWDIO
PA14.Signal=SYS_JTCK-SWCLK
PA15.Signal=GPIO_Input
PA2.Signal=ADCx_IN2
PA3.Signal=ADCx_IN3
PA4.Signal=ADCx_IN4
PA5.Signal=GPIO_Input
PA8.Signal=GPIO_Input
PA9.Signal=USART1_TX
PB1.Signal=GPIO_Output
PB10.Signal=GPIO_Output
PB11.Signal=GPIO_Output
PB14.Signal=GPIO_Output
PB15.Signal=GPIO_Output
PB3.Signal=GPIO_Input
PB4.Signal=GPIO_Input
PB5.Signal=GPIO_Output
PB6.Signal=I2C1_SCL
PB7.Signal=I2C1_SDA
PB8.Signal=CAN_RX
PB9.Signal=CAN_TX
PC13-TAMPER-RTC.Signal=GPIO_Output
PC14-OSC32_IN.Signal=GPIO_Input
PC15-OSC32_OUT.Signal=GPIO_Input
PD0-OSC_IN.Signal=RCC_OSC_IN
PD1-OSC_OUT.Signal=RCC_OSC_OUT
