LPhat24/Battery-Management-System-NCKH2026/Software/Slave1/Core/Src/main.c

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
/* Includes ------------------------------------------------------------------*/
#include "main.h"

/* USER CODE BEGIN Includes */
#include "math.h"

/* USER CODE END Includes */

/* USER CODE BEGIN PD */

#define CAN_ID_SLAVE1_TX        0x101U
#define CAN_ID_SLAVE2_TX        0x102U
#define CAN_ID_SLAVE3_TX        0x103U
#define CAN_ID_SLAVE1_RX        0x200U
#define CAN_ID_SLAVE2_RX        0x201U
#define CAN_ID_SLAVE3_RX        0x202U

/* USER CODE END PD */

ADC_HandleTypeDef hadc1;
DMA_HandleTypeDef hdma_adc1;

CAN_HandleTypeDef hcan;

TIM_HandleTypeDef htim2;

/* USER CODE BEGIN PV */

volatile uint8_t balance_mask = 0x00; 

volatile uint16_t adc_val[7];
volatile uint8_t  adc_ready = 0;
volatile uint8_t  tim_flag  = 0;

float    temperature  = 0.0f;
uint32_t ntc_ema      = 0;
uint8_t  ntc_ema_init = 0;   

uint16_t adc_buf[7];

uint16_t voltage_mV[5];
uint16_t tapVolt[5];


uint8_t bal_state[5] = {0};
uint8_t temp_cutoff  = 0;

CAN_TxHeaderTypeDef TxHeader;
uint32_t            TxMailbox;
uint8_t             TxData[8];

volatile uint32_t tx_count = 0;
volatile uint32_t can_error = 0;
volatile uint8_t  balance_enable = 1;

CAN_FilterTypeDef sFilterConfig;
CAN_RxHeaderTypeDef RxHeader;
uint8_t RxData[8];

/* CAN diagnostics */
volatile uint32_t rx_count             = 0;
volatile uint32_t error_callback_count = 0;
volatile uint8_t  last_rx_id           = 0;
volatile uint8_t  last_rx_dlc          = 0;
uint8_t           last_rx_data[8]      = {0};

uint16_t voltage_mV_f[5]  = {0};  

// Per-cell calibration factors (real / measured).
// These were computed from a one-shot calibration and can be adjusted.
// Cell order: 1..5
// Updated cell 1 calibration: actual 4011mV / measured 4015mV
// Computed factor = 4011.0 / 4015.0 = 0.99900348
// Updated cell 2 calibration: actual 3992mV / measured 3975mV
// Computed factor = 3992.0 / 3975.0 = 1.004278
/* Per-cell calibration factors (real / measured) - cell1 updated from measurement */
/* Reset calibration factors to 1.0 for re-calibration start */
/////////float calib_factor[5] = {1.0f, 0.985181093f, 0.978729188f, 0.986271262f, 1.02426493f};
float calib_factor[5] = {0.994438827f, 0.981217146f, 0.973527968f, 0.980475605f, 1.01685679f};


/* calibration/results storage */

/* ADC / divider constants */
#define ADC_MAX_VALUE        4095u
#define ADC_CHANNEL_COUNT    7u
#define CELL_COUNT           5u
#define ADC_FILTER_SHIFT     4u
#define CELL_FILTER_SHIFT    3u
#define SAMPLE_SKIP          4u
static uint16_t last_avg_adc[CELL_COUNT] = {0};
static uint8_t adc_filter_initialized = 0u;
static uint8_t cell_filter_initialized = 0u;
static uint16_t sample_skip_idx = 0;
static uint32_t adc_vdda_mv = 3300u;
static const uint32_t VREFINT_MV = 1200u;

/* Divider resistor values in ohms for each tap (R1 = top resistor, R2 = bottom to GND)
  Tap 1 = top of cell1, Tap 2 = top of cell2, ... Tap5 = top of cell5
  Values provided by hardware design */
static const uint32_t divider_R1[CELL_COUNT] = {100000u, 200000u, 300000u, 500000u, 860000u};
static const uint32_t divider_R2[CELL_COUNT] = {100000u, 100000u, 100000u, 100000u, 100000u};

/* USER CODE END PV */

void SystemClock_Config(void);
static void MX_GPIO_Init(void);
static void MX_DMA_Init(void);
static void MX_ADC1_Init(void);
static void MX_TIM2_Init(void);
static void MX_CAN_Init(void);
/* USER CODE BEGIN 0 */

/* Convert raw ADC value for a given tap index to tap voltage in mV */
static uint16_t adc_raw_to_tap_mv(uint16_t raw_adc, uint8_t tap_index)
{
  /* convert ADC code to measured millivolts
     use measured VREF to reduce systematic error */
  float v_adc_mv = ((float)raw_adc * (float)adc_vdda_mv) / (float)ADC_MAX_VALUE;

  /* divider multiplier = (R1 + R2) / R2 */
  float mult = ((float)divider_R1[tap_index] + (float)divider_R2[tap_index]) / (float)divider_R2[tap_index];

  float tap_mv = v_adc_mv * mult;
  if (tap_mv < 0.0f) tap_mv = 0.0f;
  if (tap_mv > 65535.0f) tap_mv = 65535.0f;
  return (uint16_t)(tap_mv + 0.5f);
}

static void update_adc_vdda_from_vrefint(uint16_t raw_vrefint)
{
    if (raw_vrefint == 0u) return;

    uint32_t new_vdda_mv = (uint32_t)(((uint64_t)VREFINT_MV * (uint64_t)ADC_MAX_VALUE) / (uint64_t)raw_vrefint);
    if (new_vdda_mv < 2500u || new_vdda_mv > 3600u) return;

    adc_vdda_mv = (adc_vdda_mv * 7u + new_vdda_mv) / 8u;
}
      
void HAL_ADC_ConvCpltCallback(ADC_HandleTypeDef* hadc)
{
    if (hadc->Instance == ADC1)
    {
        adc_ready = 1;
    }
}

void HAL_TIM_PeriodElapsedCallback(TIM_HandleTypeDef *htim)
{
    if (htim->Instance == TIM2)
        tim_flag = 1;
}

void calcCellVolt(void)
{
  /* compute tap voltages directly from raw ADC (mV) */
  for (uint8_t i = 0; i < CELL_COUNT; i++) {
    /* use averaged ADC value when available (otherwise 0 until filled) */
    uint16_t raw_adc = last_avg_adc[i];
    tapVolt[i] = adc_raw_to_tap_mv(raw_adc, i);
  }

  /* compute individual cell voltages by differencing consecutive taps */
  voltage_mV[0] = tapVolt[0];
  for (uint8_t i = 1; i < CELL_COUNT; i++) {
    if (tapVolt[i] > tapVolt[i - 1])
      voltage_mV[i] = tapVolt[i] - tapVolt[i - 1];
    else
      voltage_mV[i] = 0u;
  }

  /* apply calibration factors (currently 1.0) and saturate */
  for (uint8_t i = 0; i < CELL_COUNT; i++) {
    float scaled = (float)voltage_mV[i] * calib_factor[i];
    if (scaled < 0.0f) scaled = 0.0f;
    if (scaled > 65535.0f) scaled = 65535.0f;
    voltage_mV[i] = (uint16_t)(scaled + 0.5f);
  }
}

void filterVoltage(void)
{
  for (uint8_t i = 0; i < CELL_COUNT; i++) {
    if (voltage_mV[i] < 500u) {
      voltage_mV_f[i] = 0u;
      continue;
    }

    if (!cell_filter_initialized) {
      voltage_mV_f[i] = voltage_mV[i];
    } else {
      int32_t error = (int32_t)voltage_mV[i] - (int32_t)voltage_mV_f[i];
      voltage_mV_f[i] = (uint16_t)((int32_t)voltage_mV_f[i] + (error >> CELL_FILTER_SHIFT));
    }
  }
  cell_filter_initialized = 1u;
}

float NTC_GetTemperature(uint16_t adc_value)
{
    if(adc_value == 0 || adc_value >= 4095)
    {
        return -273.15f; 
    }

    float vdda = (float)adc_vdda_mv / 1000.0f;
    float voltage = (float)adc_value * vdda / 4095.0f;
    float r_ntc = 10000.0f * (vdda - voltage) / voltage;

    float A = 0.001129148f;
    float B = 0.000234125f;
    float C = 0.0000000876741f;

    float lnR = logf(r_ntc); 
    float temp_kelvin = 1.0f / (A + (B * lnR) + (C * lnR * lnR * lnR));
    
    return temp_kelvin - 273.15f; 
}

void calcTemperature(void)
{
    uint16_t raw_ntc = adc_buf[5];
    if (raw_ntc == 0) return;
	
    static uint16_t median_buf[5] = {0};
    static uint8_t  median_idx    = 0;
    static uint8_t  median_full   = 0;

    median_buf[median_idx] = raw_ntc;
    median_idx = (median_idx + 1) % 5;
    if (median_idx == 0) median_full = 1;

    uint16_t sorted[5];
    uint8_t  count = median_full ? 5 : median_idx;
    for (int i = 0; i < count; i++)
        sorted[i] = median_buf[i];
    for (int i = 0; i < count - 1; i++)
        for (int j = 0; j < count - i - 1; j++)
            if (sorted[j] > sorted[j+1]) {
                uint16_t tmp = sorted[j];
                sorted[j]    = sorted[j+1];
                sorted[j+1]  = tmp;
            }
    uint16_t median_ntc = sorted[count / 2];

    if (!ntc_ema_init) {
        ntc_ema      = (uint32_t)median_ntc << 4;
        ntc_ema_init = 1;
        temperature  = NTC_GetTemperature(median_ntc);
        return;
    }

    uint16_t prev = (uint16_t)(ntc_ema >> 4);

		if (median_ntc < prev - 10) {
				ntc_ema = ntc_ema - (ntc_ema >> 2) + median_ntc; 
		} else {
				ntc_ema = ntc_ema - (ntc_ema >> 4) + median_ntc;
		}
    uint16_t filtered_ntc = (uint16_t)(ntc_ema >> 4);
    temperature = NTC_GetTemperature(filtered_ntc);
}

void control_balance(void)
{
    const uint16_t control_PIN[5] = {
        GPIO_PIN_8, GPIO_PIN_9, GPIO_PIN_10,
        GPIO_PIN_11, GPIO_PIN_12
    };

    if (!temp_cutoff && temperature > 60.0f)
        temp_cutoff = 1;
    else if (temp_cutoff && temperature < 55.0f)
        temp_cutoff = 0;

    if (temp_cutoff || !balance_enable) {
        for (int i = 0; i < 5; i++) bal_state[i] = 0;
        HAL_GPIO_WritePin(GPIOA,
            GPIO_PIN_8|GPIO_PIN_9|GPIO_PIN_10|
            GPIO_PIN_11|GPIO_PIN_12, GPIO_PIN_RESET);
        return;
    }

    for (int i = 0; i < 5; i++) {
        uint8_t master_cmd = (balance_mask >> i) & 0x01;

        if (master_cmd)
            bal_state[i] = 1;
        else
            bal_state[i] = 0;

        HAL_GPIO_WritePin(GPIOA, control_PIN[i],
            bal_state[i] ? GPIO_PIN_SET : GPIO_PIN_RESET);
    }
}

void HAL_CAN_RxFifo0MsgPendingCallback(CAN_HandleTypeDef *hcan)
{
    HAL_CAN_GetRxMessage(hcan, CAN_RX_FIFO0, &RxHeader, RxData);
    rx_count++;
    can_error = HAL_CAN_GetError(hcan);
    last_rx_id  = RxHeader.StdId;
    last_rx_dlc = RxHeader.DLC;
    for (int i = 0; i < 8; i++) last_rx_data[i] = RxData[i];

    // Slave 1: 0x200 | Slave 2: 0x201 | Slave 3: 0x202
    if (RxHeader.StdId == CAN_ID_SLAVE1_RX) { 
        balance_enable = RxData[0] & 0x01;
        balance_mask   = RxData[1]; 
    }
    HAL_CAN_ActivateNotification(hcan, CAN_IT_RX_FIFO0_MSG_PENDING);
}

void HAL_CAN_ErrorCallback(CAN_HandleTypeDef *hcan)
{
    error_callback_count++;
    can_error = HAL_CAN_GetError(hcan);
}

/* USER CODE END 0 */

/**
  * @brief  The application entry point.
  * @retval int
  */
int main(void)
{

  /* MCU Configuration--------------------------------------------------------*/

  /* Reset of all peripherals, Initializes the Flash interface and the Systick. */
  HAL_Init();

  /* Configure the system clock */
  SystemClock_Config();

  /* Initialize all configured peripherals */
  MX_GPIO_Init();
  MX_DMA_Init();
  MX_ADC1_Init();
  MX_TIM2_Init();
  MX_CAN_Init();
  /* USER CODE BEGIN 2 */

  ADC1->CR2 |= ADC_CR2_TSVREFE;
  HAL_Delay(1);
  HAL_ADC_Start_DMA(&hadc1, (uint32_t*)adc_val, ADC_CHANNEL_COUNT);
	HAL_TIM_Base_Start_IT(&htim2);
	
	HAL_CAN_Start(&hcan);
	TxHeader.DLC   = 8;
	TxHeader.IDE   = CAN_ID_STD;
	TxHeader.RTR   = CAN_RTR_DATA;
	TxHeader.StdId = 0x101;
	
	sFilterConfig.FilterActivation     = CAN_FILTER_ENABLE;
	sFilterConfig.FilterFIFOAssignment = CAN_FILTER_FIFO0;
	sFilterConfig.FilterMode           = CAN_FILTERMODE_IDMASK;
	sFilterConfig.FilterIdHigh         = CAN_ID_SLAVE1_RX << 5;
	sFilterConfig.FilterIdLow          = 0;
	sFilterConfig.FilterMaskIdHigh     = 0x7FF << 5;
	sFilterConfig.FilterMaskIdLow      = 0;
	sFilterConfig.FilterScale          = CAN_FILTERSCALE_32BIT;
	sFilterConfig.FilterBank           = 0;
	HAL_CAN_ConfigFilter(&hcan, &sFilterConfig);
	HAL_CAN_ActivateNotification(&hcan, CAN_IT_RX_FIFO0_MSG_PENDING | CAN_IT_ERROR);

  /* USER CODE END 2 */

  /* Infinite loop */
  /* USER CODE BEGIN WHILE */
  while (1)
  {
    /* USER CODE END WHILE */

    /* USER CODE BEGIN 3 */
   if (adc_ready) {
    __disable_irq();
    for (int i = 0; i < ADC_CHANNEL_COUNT; i++)
        adc_buf[i] = adc_val[i];
    adc_ready = 0;
    __enable_irq();
  update_adc_vdda_from_vrefint(adc_buf[6]);
   /* Low-pass each tap continuously; unlike block averaging it cannot step. */
   sample_skip_idx = (sample_skip_idx + 1) % SAMPLE_SKIP;
   if (sample_skip_idx == 0) {
     for (uint8_t i = 0; i < CELL_COUNT; i++) {
       if (!adc_filter_initialized)
         last_avg_adc[i] = adc_buf[i];
       else
         last_avg_adc[i] = (uint16_t)((int32_t)last_avg_adc[i] +
             (((int32_t)adc_buf[i] - (int32_t)last_avg_adc[i]) >> ADC_FILTER_SHIFT));
     }
     adc_filter_initialized = 1u;
   }

  }

  if (tim_flag) {
    tim_flag = 0;

    calcTemperature();
    calcCellVolt();
    filterVoltage();
    control_balance();

    /* Two-frame CAN: Frame A contains 4 cells (u16 each), Frame B contains cell5 (u16),
       temperature in tenths (int16), mosfet mask (u8) and seq (u8) */
    static uint8_t seq = 0;
    uint8_t TxA[8];
    uint8_t TxB[6];

    /* Prepare cell values (mV) - use filtered calibrated values */
    uint16_t c[5];
    for (int i = 0; i < 5; i++) {
      c[i] = voltage_mV_f[i];
    }

    /* Frame A: cells 1..4 as little-endian uint16 */
    for (int i = 0; i < 4; i++) {
      TxA[2*i]   = (uint8_t)(c[i] & 0xFF);
      TxA[2*i+1] = (uint8_t)((c[i] >> 8) & 0xFF);
    }

    /* Transmit Frame A */
    TxHeader.DLC = 8;
    if (HAL_CAN_GetTxMailboxesFreeLevel(&hcan) == 0) {
      HAL_CAN_AbortTxRequest(&hcan, CAN_TX_MAILBOX0);
      HAL_CAN_AbortTxRequest(&hcan, CAN_TX_MAILBOX1);
      HAL_CAN_AbortTxRequest(&hcan, CAN_TX_MAILBOX2);
    }
    if (HAL_CAN_AddTxMessage(&hcan, &TxHeader, TxA, &TxMailbox) == HAL_OK)
      tx_count++;

    /* Frame B: cell5, temperature in tenths (int16), mask, seq */
    int16_t temp_tenths = 0;
    if (!isnan(temperature) && temperature > -1000.0f && temperature < 1000.0f)
      temp_tenths = (int16_t)(temperature * 10.0f + (temperature >= 0 ? 0.5f : -0.5f));

    TxB[0] = (uint8_t)(c[4] & 0xFF);
    TxB[1] = (uint8_t)((c[4] >> 8) & 0xFF);
    TxB[2] = (uint8_t)(temp_tenths & 0xFF);
    TxB[3] = (uint8_t)((temp_tenths >> 8) & 0xFF);
    uint8_t mosfet = 0;
    for (int i = 0; i < 5; i++) mosfet |= (bal_state[i] & 0x01) << i;
    TxB[4] = mosfet;
    TxB[5] = seq++;

    TxHeader.DLC = 6;
    if (HAL_CAN_GetTxMailboxesFreeLevel(&hcan) == 0) {
      HAL_CAN_AbortTxRequest(&hcan, CAN_TX_MAILBOX0);
      HAL_CAN_AbortTxRequest(&hcan, CAN_TX_MAILBOX1);
      HAL_CAN_AbortTxRequest(&hcan, CAN_TX_MAILBOX2);
    }
    if (HAL_CAN_AddTxMessage(&hcan, &TxHeader, TxB, &TxMailbox) == HAL_OK)
      tx_count++;

    can_error = HAL_CAN_GetError(&hcan);
    HAL_GPIO_TogglePin(GPIOC, GPIO_PIN_13);

    if (can_error & HAL_CAN_ERROR_BOF) {
      HAL_CAN_Stop(&hcan);
      HAL_CAN_Start(&hcan);
    }
}
}
  /* USER CODE END 3 */
}

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
