LPhat24/Battery-Management-System-NCKH2026/Software/Slave1/Core/Inc/main.h

#define CONTROL_1_Pin GPIO_PIN_8
#define CONTROL_1_GPIO_Port GPIOA
#define CONTROL_2_Pin GPIO_PIN_9
#define CONTROL_2_GPIO_Port GPIOA
#define CONTROL_3_Pin GPIO_PIN_10
#define CONTROL_3_GPIO_Port GPIOA
#define CONTROL_4_Pin GPIO_PIN_11
#define CONTROL_4_GPIO_Port GPIOA
#define CONTROL_5_Pin GPIO_PIN_12
#define CONTROL_5_GPIO_Port GPIOA
