LPhat24/Battery-Management-System-NCKH2026/Software/Master/Core/Inc/i2c-lcd.h

#include "stm32f1xx_hal.h"

void lcd_init (void);   // initialize lcd

void lcd_send_cmd (char cmd);  // send command to the lcd

void lcd_send_data (char data);  // send data to the lcd

void lcd_send_string (char *str);  // send string to the lcd

void lcd_clear (void);  
