LPhat24/Battery-Management-System-NCKH2026/(commit log)

2026-07-10 Modify position in UI, Charge control and calib factor in Slave2
2026-07-12 Modify some position and parameter BMS UI.vi
2026-07-13 feat: Add battery test figures and MATLAB script monitor
2026-07-14 Up 3th and 4th testing. Calib factor and filter cell voltage
2026-07-30 Refactor safety/precharge control and fix ADC/DMA for LCD operation
    - Change PA5 from ADC_IN5 to GPIO input with pull-up for charge detection
    - Reduce ADC channels from 6 to 5 (remove ADC_IN5), keep scan+continuous DMA
    - Restore DMA init and circular mode for ADC (was removed, causing LCD freeze)
    - Re-enable HAL_DMA_MODULE_ENABLED in HAL config (was accidentally disabled)
    - Rewrite Safety_Control: use PB1/PB10/PB11 fault cutoff, PB14 charge inhibit
    - Restructure Precharge_Handle: add PB1 relay, reduce timer 5s->3s
    - Add Fan_Control on PB5 with 27.5°C threshold
    - Remove TIM3 PWM and all TIM HAL drivers (no longer used)
    [Master.ioc, main.c, main.h]
2026-07-30 Add PCB design files for Master Board
    [PCB_PCB_VIP_Master BMS 2026.json, PCB_VIP_Master BMS 2026.json]
2026-08-02 Add enclosure and slave board PCB design files
    [Battery5s2p.SLDPRT, Bottom.SLDPRT, Bottom2.SLDPRT, KARE AKS0YEL FAN_80x80x25 FAN.STEP, LCD 2004 +I2C.stp, LCD Display 2004.stp, LargeEdge.SLDPRT, LargeEdge_Right.SLDPRT]
2026-08-03 Update enclosure design with SolidWorks source files
    [18650 2PCS KEEPER.SLDPRT, 5s2p Battery.SLDASM, Battery5s2p.SLDPRT, Bottom.SLDPRT, Bottom2.SLDPRT, Cell.SLDPRT, FAN_80x80x25.SLDPRT, KARE AKS0YEL FAN_80x80x25 FAN.STEP]
2026-08-04 Add enclosure drawings and mica box design
    [Bottom2.DXF, LargeEdge.DXF, LargeEdge.SLDDRW, LargeEdge_Right.DXF, SmallEdge.DXF, SmallEdge_OUTPUT.DXF, SmallEdge_OUTPUT.SLDDRW, Top Custom.SLDDRW]
2026-08-15 Add box design PDFs and update SolidWorks drawings
    [LargeEdge.SLDDRW, SmallEdge_OUTPUT.SLDDRW, Top Custom.SLDDRW]
2026-08-15 Sync CAN config across master and slaves
    - Master: switch CAN RX from FIFO1 to FIFO0 to match slave nodes
    - Master: replace accept-all filter with exact-match banks for 0x101/0x102/0x103
    - Master: use USB_LP_CAN1_RX0_IRQHandler and NVIC config in line with slaves
    - Slave1: add CAN_ID defines and use them in filter and RX callback
    [Master.ioc, main.c]
2026-08-17 Reset slave calibration factors to 1.0
    [main.c]
2026-08-20 Add master and slave board design archives
2026-09-03 Implement connectivity-based PC13 LED status indicator in master
2026-09-03 Update slave cell voltage calibration factors from bench measurement
2026-09-03 Add master board PCB layer PDFs and archive
2026-09-03 Enhances safety with discharge fault and precharge control
    Introduces a `safety_fault` flag to track discharge-related safety conditions, including undervoltage and absolute overcurrent during discharge.
    Integrates this `safety_fault` into the precharge state machine:
    - Prevents precharge initiation if a fault is active.
    - Immediately deactivates precharge and main contactors during active precharge upon fault.
    - Opens contactors and returns to idle if a fault occurs while precharge is complete.
    Refactors the charge control logic (PB14) for clarity and robustness. Charging is now permitted only when the charge state is active, no cells are overvoltage, and charging current is within specif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
    [main.c]
2026-09-05 Enhance MATLAB monitor with GUI controls and fix master safety control logic
    - MATLAB ScriptMonitor: redesign with integrated Control Panel (COM selector,
    baudrate/duration settings, Start/Stop), improved serial handling and
    live plotting for pack/cell voltages
    - Master main.c: update LCD intro screens, correct ADC channel mapping for
    charge/discharge pots, fix PB14 charge-cut logic to avoid power drain
    when charger not connected
    [main.c]
2026-09-06 Add window-based balancing, auto MATLAB monitor, and PCB docs
    - Master: implement hysteresis window [3,10] mV on global spread and per-cell latches to suppress switching-noise LED flicker; gate on SW_Balancing and temperature
    - Master: append SW_LabVIEW state to CSV telemetry for monitor verification
    - MATLAB: add AutoMonitor (fixed COM5/115200) with handle-unpack fix and acquisition diagnostics; add TestUartSending; update ScriptMonitor ports/timeouts/counters
    - Docs: replace Master PCB zip/PDFs with MASTER/SLAVE PCB layout and schematic exports; add MATLAB figure exports
    [main.c]
2026-09-06 Polish monitoring UI and rename telemetry switch to UART
    - Rename SW_LabVIEW to SW_UART in master firmware and MATLAB monitors
    - Fix AutoMonitor Y-axis formatting and add dynamic scaling for pack plots
    - Merge monitoring interface into single figure with left 50%% / right 50%% layout
    - Fix DPI clipping and label overlaps at 1920x1080 125%% scaling
    - Add acceptance testing figure (dv400mV)
    [main.c]
2026-09-07 Update LabVIEW UI and add DAMH presentation slides
    - Refresh LabVIEW BMS UI VI
    - Add Le Thanh Phat DAMH slide deck
2026-09-09 Fix passive balancing convergence and quiet-window ADC capture
    Master: locked per-cell latch constants (BAL_ON 25 / BAL_OFF 8 / spread-off 6 mV), global hold until spread < 6 mV, 40/35 C thermal heat_cutoff latch; latches preserved across thermal cutoff.
    Slaves: sample OCV in quiet window with balance FETs off using one fresh DMA round (7-channel rank order) instead of per-channel PollForConversion, which STM32F1 cannot do inside a scan sequence; fixes cells 5/10 misreads.
    Slaves: 40/35 C temp_cutoff latch on balance output.
    [main.c]
2026-09-09 Update LabVIEW UI and add 5S2P battery pack Simulink model
2026-09-11 Simplify passive balancing thresholds and add MATLAB BuildGraph script
    [BMS_TESTING.csv]
2026-09-11 Remove leading 202 s of test data and add experiment plot
    [BMS_TESTING.csv]
2026-10-11 feat(bms): add per-cell passive balancing hysteresis and thermal gate
2026-10-11 feat(ui): update LabVIEW BMS monitoring UI
2026-10-11 sim(bms): update MATLAB Simulink Two5s2p model
2026-10-29 feat(bms): add PB15 fault buzzer for safety alarms
    Drive PB15 as an audible warning when a protection event is active:
    500 ms on / 500 ms off, five cycles, then silence until the fault
    clears and re-occurs.
    Safety_Control() now returns a bitmask (discharge fault, charge cut)
    instead of void, so the alarm cause is aggregated without introducing
    another global. Contactor and charge-control behaviour is unchanged;
    the buzzer is advisory only and assumes an active-high driver.
    Keil: 0 errors, 1 pre-existing warning.
2026-10-29 feat(bms): update Master intro screen for Eureka 2026
    Replace the advisor line on intro screen 2 with the event banner
    "Eureka 2026" (the original call is kept as a comment) and correct
    the second student name to "Le Thanh Phat".
